seanrieb/daq/README.md

# daq
Data Acquisition Board

Add SparkFun to Arduino IDE board Manager URLs:

https://raw.githubusercontent.com/sparkfun/Arduino_Boards/main/IDE_Board_Manager/package_sparkfun_index.json

Board will be the Pro Micro
