seanrieb/daq/hw/EAGLE/DAQAccel/DAQAccel BOM.xlsx

Qty | Onhand | Vendor | Vendor P/N | Value | Device | Package | Parts | Description
6 | 15 | Mouser | 710-885382206004 | 100nF | CAP-0603 | C0603 | C2, C3, C5, C6, C7, C11 | Ceramic Capacitors
6 | 0 | Mouser | 187-CL10B105KA8NNNC | 1uF | CAP-0603 | C0603 | C1, C4, C8, C9, C10, C12 | Ceramic Capacitors
4 | 12 | Mouser | 512-2N7002L | 2N7002 | MOSFET-N'SOT23' | SOT-23 | Q1, Q2, Q3, Q4 | IRLL014:
8 | 3 | Mouser | 660-RK73B1JTTDD472J | 4.7k | RES-0603 | R0603 | R1, R2, R3, R4, R5, R8, R9, R10
1 | 0 | Mouser | 710-634008149821 | 634008149821 | 634008149821 | 634008149821 | J1 | WR-MJ Modular Jack Horizontal Shielded SMT 8P8C Tab Up
1 |  |  |  | ADXL357 | SENSOR-ADXL357BEZ | LCC-14-TERMINAL | U1
2 |  |  |  | DNP | RES-0603 | R0603 | R6, R7
10 |  |  |  | Test | TEST-POINT'4545' | TP-D45MIL | TP1, TP2, TP3, TP4, TP5, TP6, TP7, TP8, TP9, TP10
1 | 1 | Mouser | 621-AP2125N-3.0TRG1 | XC6206P302MR | PMIC-XC6206PMR | SOT-23 | U2 | LOW ESR Cap.Compatible Positive Voltage Regulators
