seanrieb/daq/hw/EAGLE/DAQShield/DAQShield BOM.xlsx

 | BUILD | 8
Qty | Onhand | Need | Vendor | Vendor P/N | Value | Device | Package | Parts | Description
1 | 11 | -3 | Amazon |  | ARDUINO_PRO_MICRO | ARDUINO_PRO_MICRO | ARDUINO_PRO_MICRO | A1
3 | 167 | -143 | Mouser | 187-CL10A105KA8NFNC | 1u | C-EUC0603 | C0603 | C1, C6, C8 | CAPACITOR, European symbol
1 | 5 | 3 | Mouser | 963-UMK325C7106MM-T | 10u | C-EUC1210 | C1210 | C2 | CAPACITOR, European symbol
2 | 8 | 8 | Mouser | 187-CL10B334KO8NNNC | 0.33u | C-EUC0603 | C0603 | C27, C47 | CAPACITOR, European symbol
2 | 16 | 0 | Mouser | 963-JMK107ABJ106KA-T | 10u | C-EUC0603 | C0603 | C28, C48 | CAPACITOR, European symbol
1 | 5 | 3 | Mouser | 791-0805B104J500CT | 0.1u | C-EUC0805 | C0805 | C3 | CAPACITOR, European symbol
41 | 734 | -406 | Mouser | 187-CL10B104JB8NNNC | 0.1u | C-EUC0603 | C0603 | C4, C7, C9, C10, C11, C12, C13, C14, C15, C16, C17, C18, C19, C20, C21, C22, C23, C24, C25, C26, C29, C30, C31, C32, C33, C34, C35, C36, C37, C38, C39, C40, C41, C42, C43, C44, C45, C46, C49, C50, C51 | CAPACITOR, European symbol
1 | 2 | 6 | Mouser | 187-CL31A106MBHNNNE | 10u | C-EUC0805 | C0805 | C5 | CAPACITOR, European symbol
1 | 5 | 3 | Mouser | 771-PMEG6010CEH-T/R | PMEG6010CEH,115 | SMF5.0AT1 | SOD123FL | D1 | 200 W Transient Voltage Suppressor
1 | 8 | 0 | Mouser | 595-SN74LVC08MDBVREP | 74AHC1G08DBV | 74AHC1G08DBV | SOT23-5 | IC1 | 2-input AND gate
2 | 4 | 12 | Mouser | 200-SSM112FSHTR |  | 6100XX13321_61001213321 | 61001213321 | J1, J2 | WR-PHD 2.54 mm SMT Socket Header
3 | 8 | 16 | Mouser | 710-634008149821 | 634008149821 | 634008149821 | 634008149821 | J3, J4, J6 | WR-MJ Modular Jack Horizontal Shielded SMT 8P8C Tab Up
1 | 1 | 7 | Newark | 45X4591 |  | 6180XX330923_618044330923 | 618044330923 | J5 | WR-DSUB Female High Density Angled PCB Connector w. Hex Screw
1 | 5 | 3 | Mouser | 652-SRU8043-330Y | 33u | SRU8043-XXXX | IND_BOURNS_SRU8043 | L1
1 | 6 | 2 | Mouser | 604-APA1606QBC/D | APA1606QBC/D | APA1606QBC/D | LED_APA1606_KNB | LED1
10 | 39 | 41 | Mouser | 71-CRCW060347R0FKEAC | 47 | R-EU_R0603 | R0603 | R1, R2, R3, R4, R5, R6, R7, R8, R9, R10 | RESISTOR, European symbol
1 | 6 | 2 | Mouser | 594-MCT06030C1100FP5 | 110 | R-EU_R0603 | R0603 | R11 | RESISTOR, European symbol
1 | 5 | 3 | Mouser | 603-RT0402FRE0757K6L | 57.6k | R-EU_R0402 | R0402 | R12 | RESISTOR, European symbol
1 | 5 | 3 | Mouser | 603-RT0805BRD0710K4L | 10.4k | R-EU_R0805 | R0805 | R13 | RESISTOR, European symbol
6 | 142 | -94 | Mouser | 603-RT0603FRD0710KL | 10k | R-EU_R0603 | R0603 | R14, R15, R17, R22, R39, R58 | RESISTOR, European symbol
1 | 0 | 8 | Mouser | 756-PCF0603R39K2BI | 39.2k | R-EU_R0603 | R0603 | R16 | RESISTOR, European symbol
1 | 0 | 8 | Mouser | 66-PCFW0603LF032002B | 20k | R-EU_R0603 | R0603 | R18 | RESISTOR, European symbol
1 | 0 | 8 | Mouser | 756-PCF0603R82K5BI | 82.5k | R-EU_R0603 | R0603 | R19 | RESISTOR, European symbol
1 | 35 | -27 | Mouser | 603-RT0603DRE07120RL | 120 | R-EU_R0603 | R0603 | R20 | RESISTOR, European symbol
26 | 114 | 94 | Mouser | 667-ERA-3AED151V | 150 | R-EU_R0603 | R0603 | R23, R24, R25, R26, R27, R28, R29, R30, R31, R32, R33, R34, R36, R42, R43, R44, R45, R46, R47, R48, R49, R50, R51, R52, R53, R55 | RESISTOR, European symbol
2 | 17 | -1 | Mouser | 667-ERA-3AEB102V | 1k | R-EU_R0603 | R0603 | R35, R54 | RESISTOR, European symbol
4 | 193 | -161 | Mouser | 603-RC0603JR-070RL | 0 | R-EU_R0603 | R0603 | R37, R38, R56, R57 | RESISTOR, European symbol
6 | 82 | -34 | Mouser | 603-RC1206JR-070RL | 0 | R-EU_R1206 | R1206 | R40, R41, R59, R60, R61, R62 | RESISTOR, European symbol
1 | 5 | 3 | Mouser | 710-434153017835 | 434153017835 | 434153017835 | 434153017835 | S1 | WS-TASV J-Bend SMT Tact Switch 3.5x2.9 mm
2 | 6 | 10 | Mouser | 710-450404015514 |  | 450404015514 | 450404015514 | S2, S4 | WS-SLSU Mini Slide Switch, Same Side Connection Side Push 6.7x2.7 mm
1 | 14 | -6 | Digikey | 428427320910-ND |  | 428427320910 | 42842732091X_10POS | S3 | WS-ROTU THT Rotary Switch Right Angled with Arrow Type Actuator, 2.54 mm Pitch, 10x10 mm
1 | 6 | 2 | Mouser | 710-452403012014 |  | 452403012014 | 452403012014 | S5 | WS-SLSV SMD Mini Slide Switch, Same Side Connection 7.65 x 5.5 mm
1 | 3 | 5 | Texas Instruments | SN74LVC1G125DBVR | Value | 74LVC1G125DBVRE4 | DBV0005A_N | U1
1 | 2 | 6 | Texas Instruments | LV2862XLVDDCT/R | LV2862XLVDDCR | LV2862XLVDDCR | DDC0006A-IPC_A | U2
1 | 7 | 1 | Mouser | 595-TPS3828-50DBVT | TPS3828-50DBVT | TPS3828-50DBVT | SOT95P280X145-5N | U3 | Check prices
1 | 6 | 2 | Mouser | 595-TPS7A0533PDBZT | XC6206P302MR | XC6206P302MR | SOT95P280X130-3N | U4 | Linear Voltage Regulator IC 1 Output 200mA SOT-23 Check prices
1 | 2 | 6 | Mouser | 700-MAX3491ECSD | MAX3491ECSD+ | MAX3491ECSD+ | SOIC127P600X175-14N | U5 | Check prices
2 | 6 | 10 | Mouser | ADS114S08BIPBSR | ADS114S08BS | ADS114S08BIPBS | PBS0032A_N | U6, U7
