seanrieb/daq/hw/EAGLE/DAQAccel/DAQAccel.step

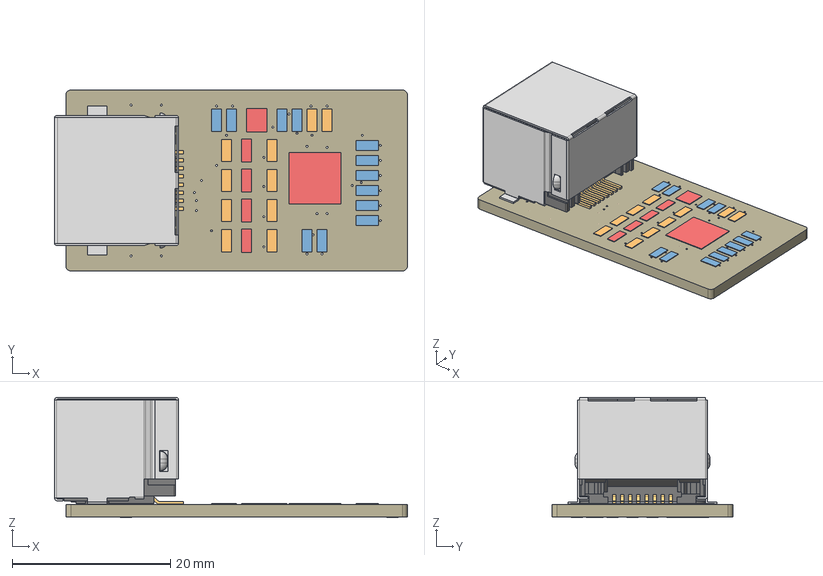
[picture p1: CAD file, 2024-06-11]
hw/EAGLE/DAQAccel/DAQAccel.step
44.6 x 22.9 x 15.2 mm
Board
1uF x 12
634008149821_Housing
634008149821_Housing2
634008149821_Pin x 8
634008149821_Shielding
2N7002 x 4
4.7k x 10
Test x 10
ADXL357
XC6206P302MR
