seanrieb/daq/hw/EAGLE/DAQShield/DAQShield.pdf

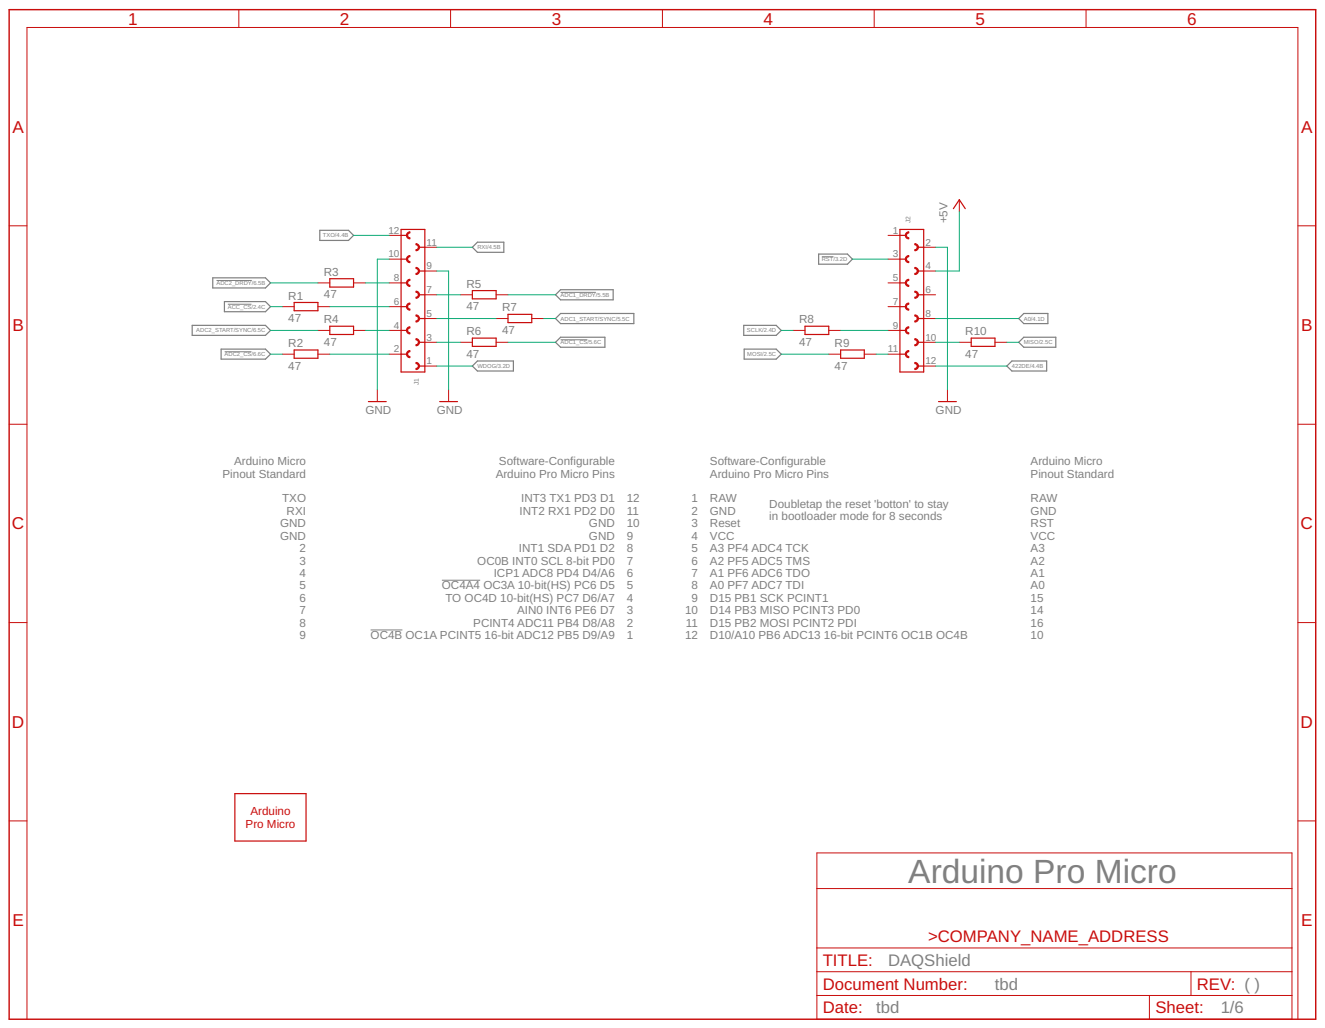
[picture p2: page 1]

Arduino Micro Pinout Standard TXO

Software-Configurable Arduino Pro Micro Pins

Software-Configurable Arduino Pro Micro Pins RAW

Arduino Micro Pinout Standard RAW

Doubletap the reset 'botton' to stay
in bootloader mode for 8 seconds

A3 PF4 ADC4 TCK
A2 PF5 ADC5 TMS
A1 PF6 ADC6 TDO
A0 PF7 ADC7 TDI D15 PB1 SCK PCINT1 D14 PB3 MISO PCINT3 PD0 D15 PB2 MOSI PCINT2 PDI D10/A10 PB6 ADC13 16-bit PCINT6 OC1B OC4B

OC4A4 OC3A 10-bit(HS) PC6 D5 TO OC4D 10-bit(HS) PC7 D6/A7 AIN0 INT6 PE6 D7 PCINT4 ADC11 PB4 D8/A8

Document Number: tbd | REV: ( )
Date: tbd | Sheet: 1/6

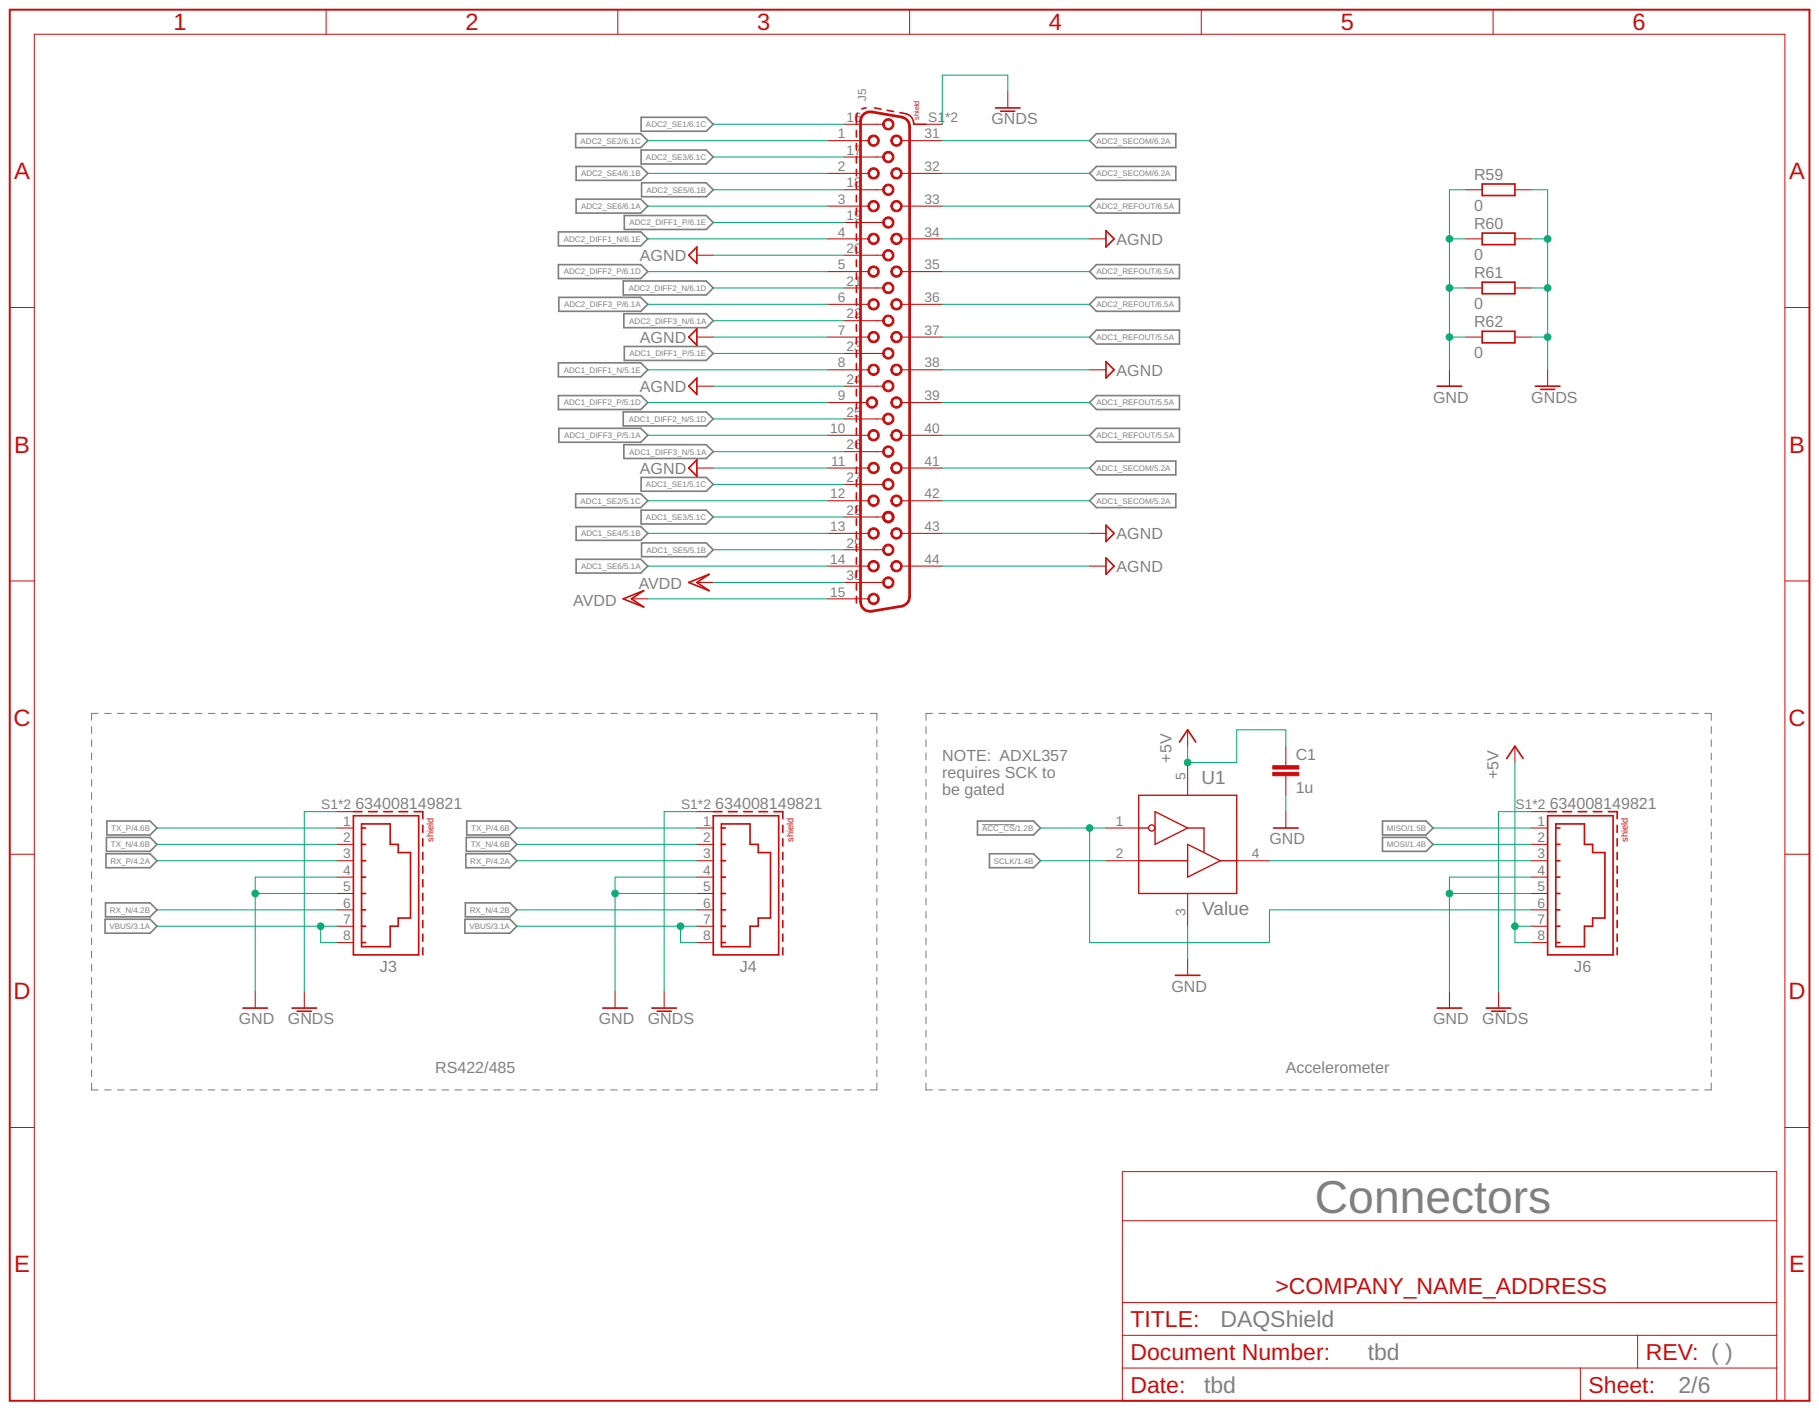
[picture p3: page 2]

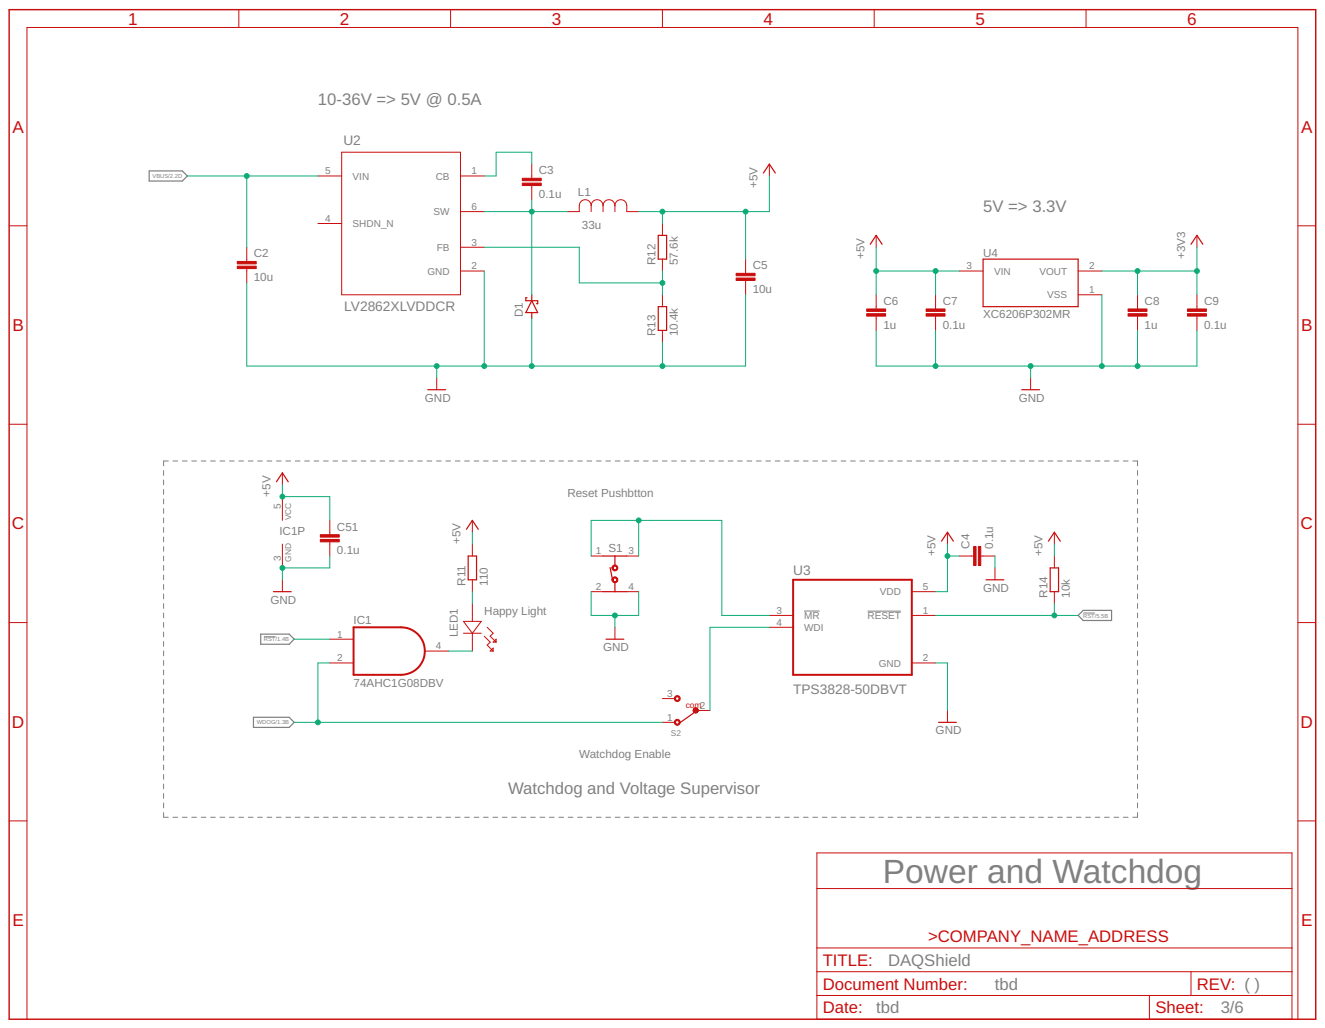
[picture p4: page 3]

2 VSS

Watchdog and Voltage Supervisor

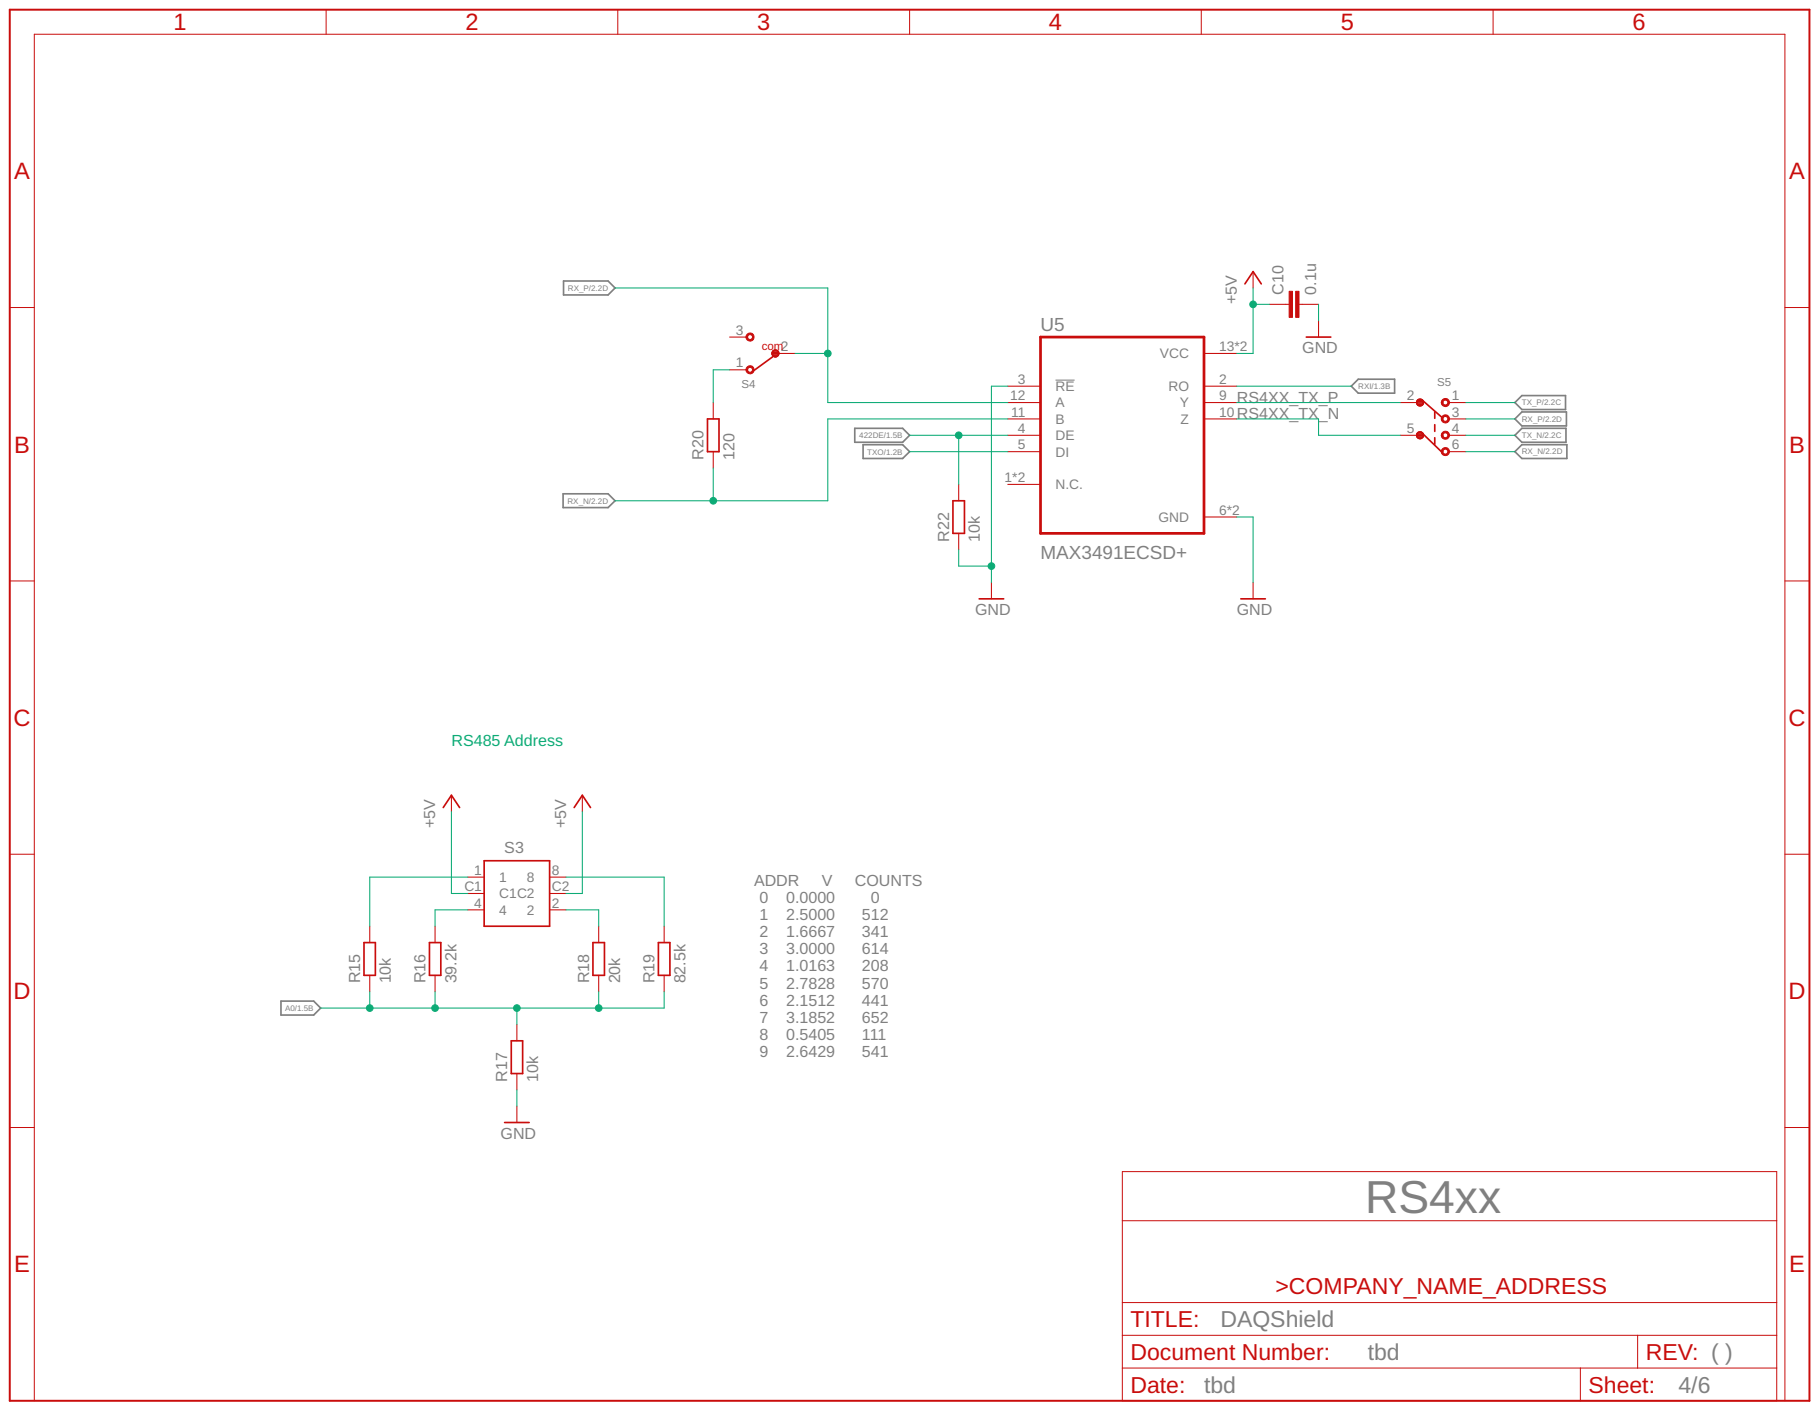
[picture p5: page 4]

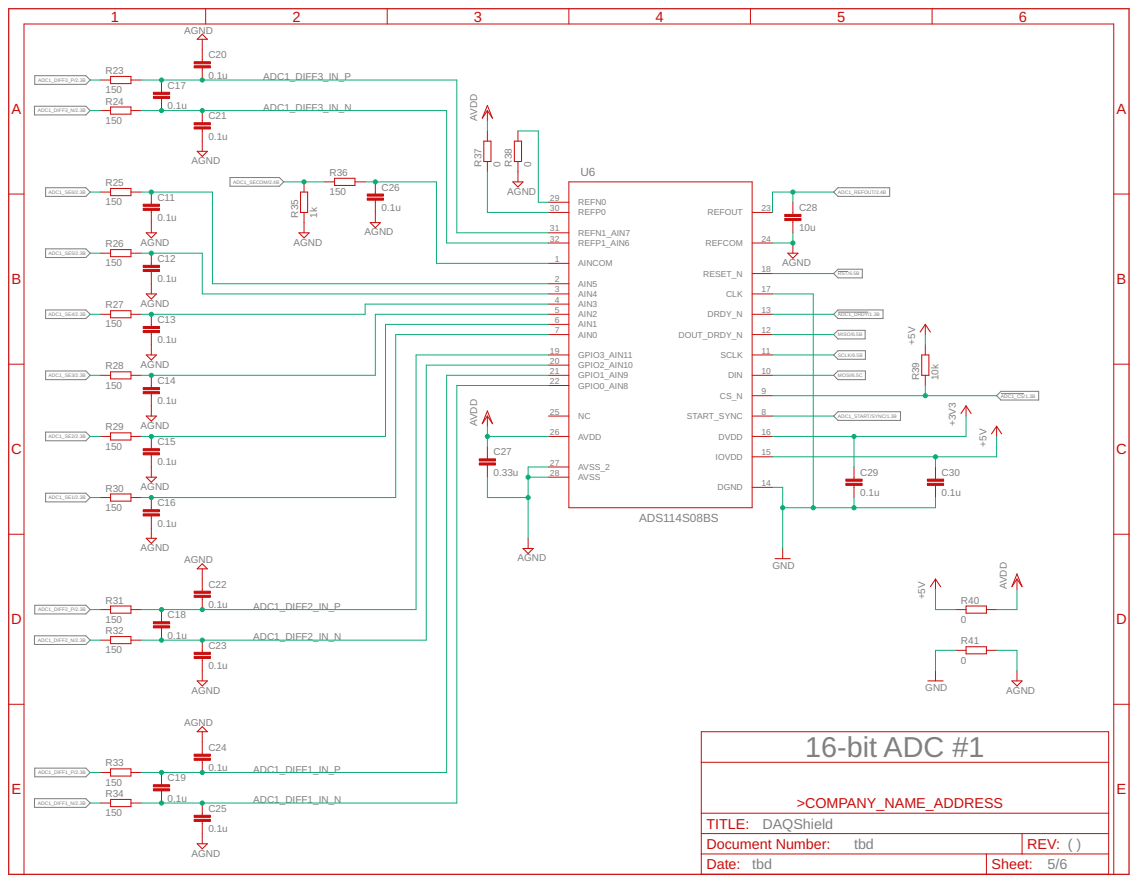
[picture p6: page 5]

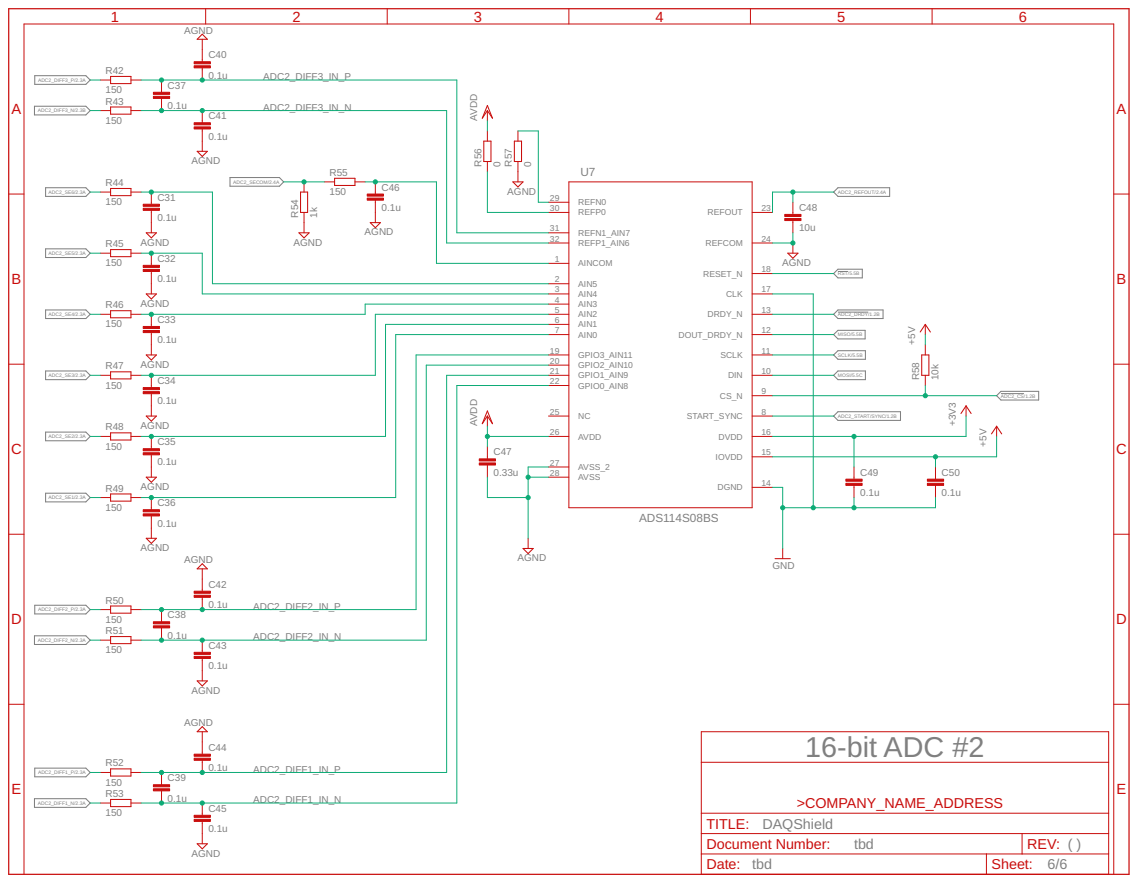
[picture p7: page 6]
