seanrieb/daq/hw/EAGLE/DAQAccel/DAQAccel.pdf

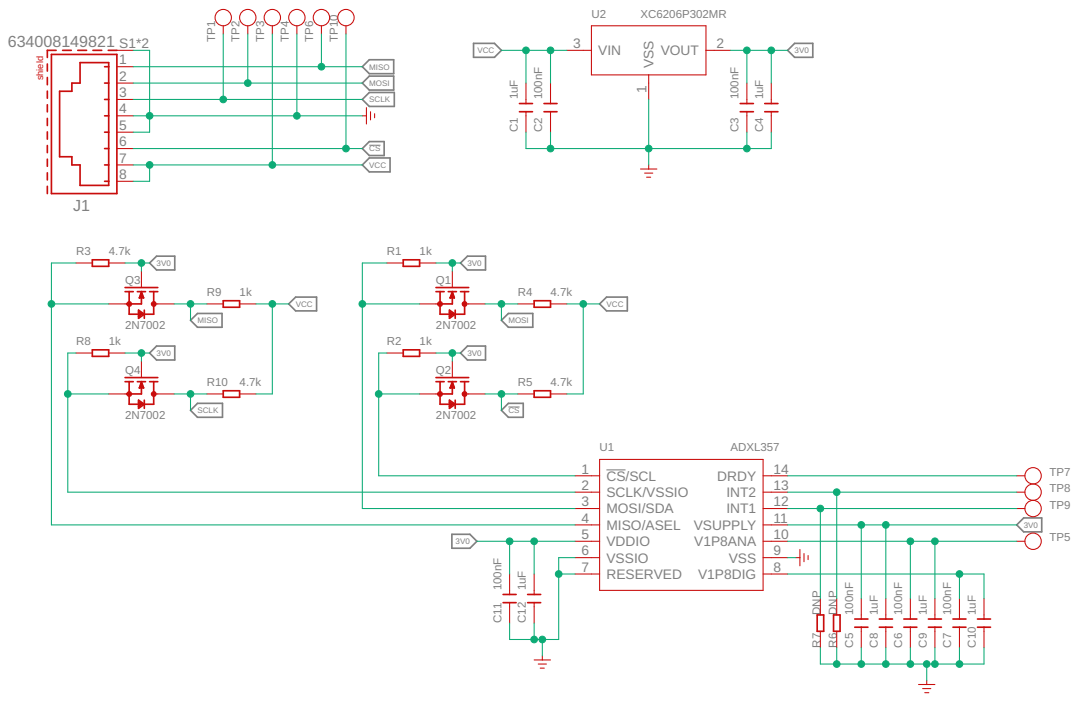
[picture p8: page 1]

4 | SCLK

8 | VCC

Document Number: tbd | REV: ( )
Date: tbd | Sheet: 1/1
