seanrieb/daq/hw/EAGLE/DAQShield/DAQShield.brd

## EAGLE design hw/EAGLE/DAQShield/DAQShield.brd (2024-06-11)

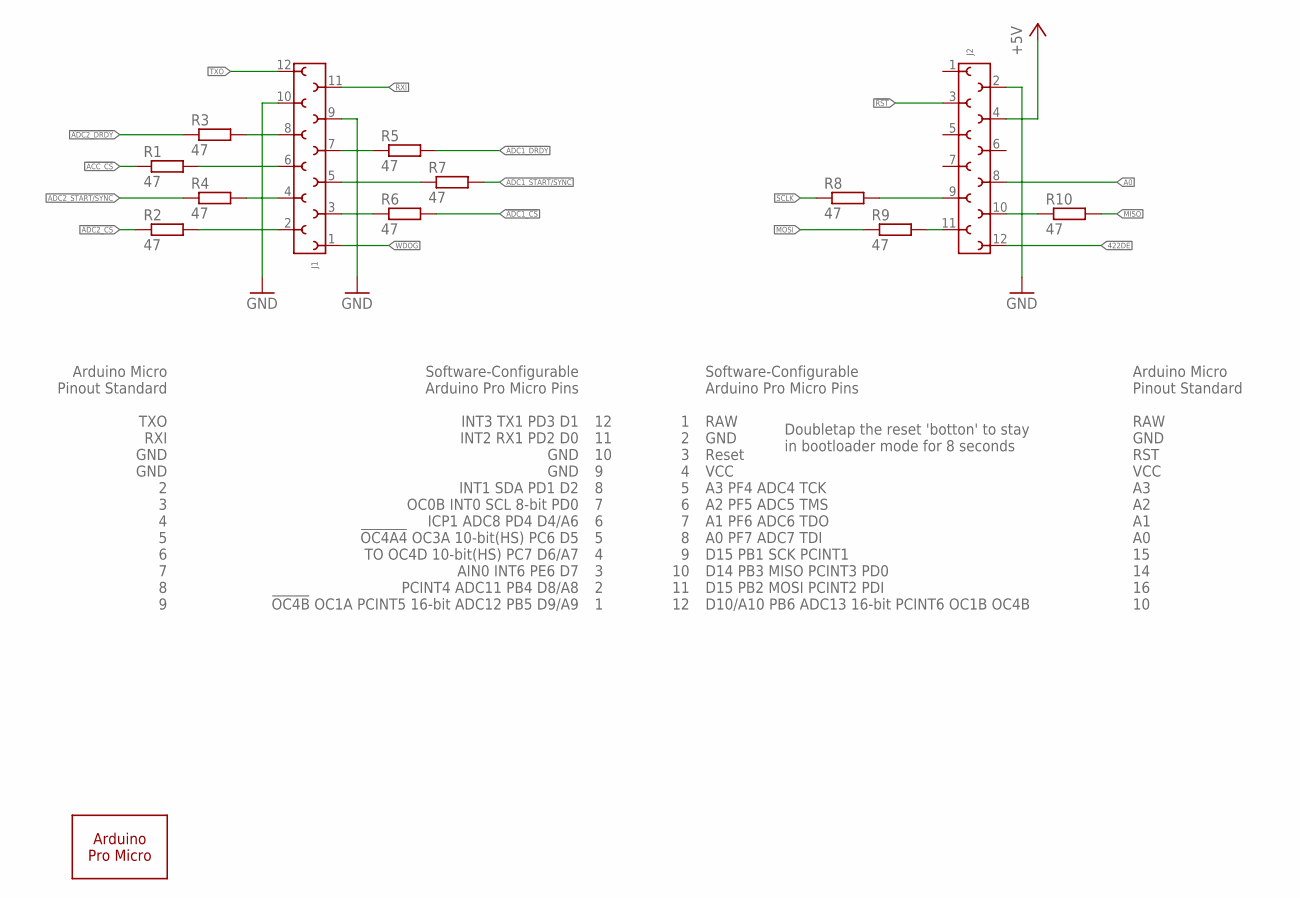
[picture p9: schematic DAQShield.sch, sheet 1, Arduino Pro Micro]

Parts:
A1: ARDUINO_PRO_MICRO
J1, J2: 6100XX13321_61001213321; 61001213321
R1, R2, R3, R4, R5, R6, R7, R8, R9, R10: 47; R0603

Connections:
422DE: J2.12; also elsewhere on the board
!ACC_CS: R1.1; also elsewhere on the board
!ADC1_CS: R6.2; also elsewhere on the board
!ADC1_DRDY: R5.2; also elsewhere on the board
!ADC2_CS: R2.1; also elsewhere on the board
!ADC2_DRDY: R3.1; also elsewhere on the board
!RST: J2.3; also elsewhere on the board
+5V: J2.4; also elsewhere on the board
A0: J2.8; also elsewhere on the board
ADC1_START/SYNC: R7.2; also elsewhere on the board
ADC2_START/SYNC: R4.1; also elsewhere on the board
GND: J1.9, J1.10, J2.2; also elsewhere on the board
MISO: R10.2; also elsewhere on the board
MOSI: R9.1; also elsewhere on the board
unnamed: J2.9, R8.2
unnamed: J2.11, R9.2
unnamed: J2.10, R10.1
unnamed: J1.8, R3.2
unnamed: J1.7, R5.1
unnamed: J1.4, R4.2
unnamed: J1.2, R2.2
unnamed: J1.5, R7.1
unnamed: J1.3, R6.1
unnamed: J1.6, R1.2
RXI: J1.11; also elsewhere on the board
SCLK: R8.1; also elsewhere on the board
TXO: J1.12; also elsewhere on the board
WDOG: J1.1; also elsewhere on the board

Notes on the sheet:
Arduino Micro Pinout Standard TXO RXI GND GND 2 3 4 5 6 7 8 9
Software-Configurable Arduino Pro Micro Pins INT3 TX1 PD3 D1 INT2 RX1 PD2 D0 GND GND INT1 SDA PD1 D2 OC0B INT0 SCL 8-bit PD0 ICP1 ADC8 PD4 D4/A6 !OC4A4! OC3A 10-bit(HS) PC6 D5 TO OC4D 10-bit(HS) PC7 D6/A7 AIN0 INT6 PE6 D7 PCINT4 ADC11 PB4 D8/A8 !OC4B! OC1A PCINT5 16-bit ADC12 PB5 D9/A9
12 11 10 9 8 7 6 5 4 3 2 1
1 2 3 4 5 6 7 8 9 10 11 12
Software-Configurable Arduino Pro Micro Pins RAW GND Reset VCC A3 PF4 ADC4 TCK A2 PF5 ADC5 TMS A1 PF6 ADC6 TDO A0 PF7 ADC7 TDI D15 PB1 SCK PCINT1 D14 PB3 MISO PCINT3 PD0 D15 PB2 MOSI PCINT2 PDI D10/A10 PB6 ADC13 16-bit PCINT6 OC1B OC4B
Arduino Micro Pinout Standard RAW GND RST VCC A3 A2 A1 A0 15 14 16 10
Doubletap the reset 'botton' to stay in bootloader mode for 8 seconds

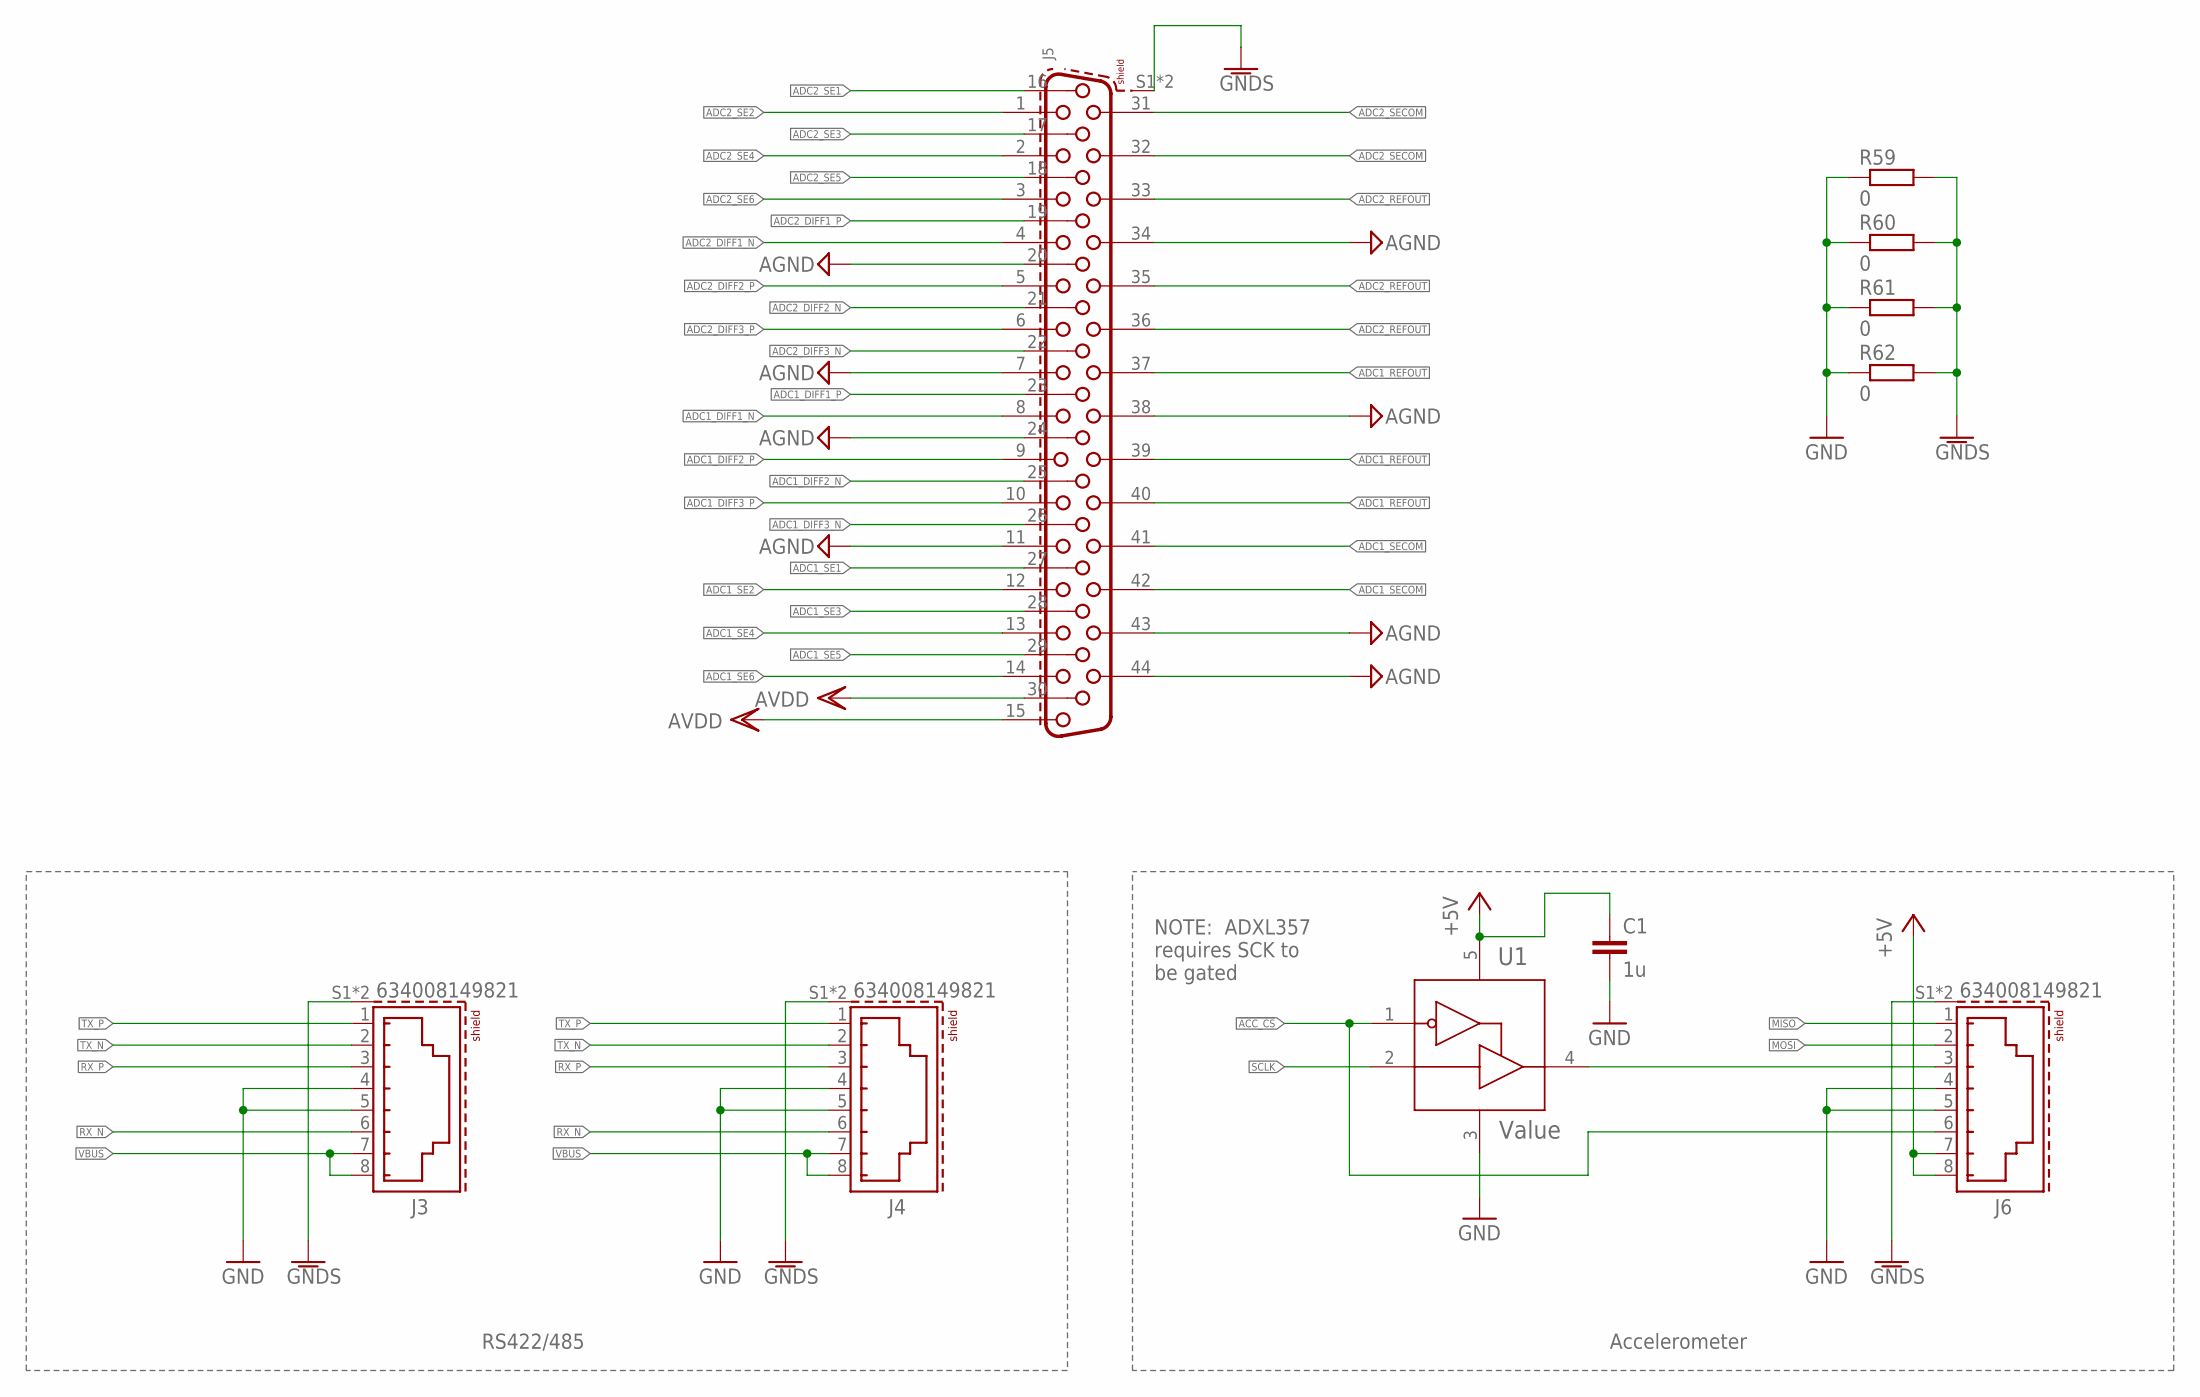
[picture p10: schematic DAQShield.sch, sheet 2, Connectors]

Parts:
C1: 1u; C0603
J3, J4, J6: 634008149821
J5: 6180XX330923_618044330923; 618044330923
R59, R60, R61, R62: 0; R1206
U1: Value; DBV0005A_N

Connections:
!ACC_CS: J6.6, U1.1 (OE_N); also elsewhere on the board
+5V: C1.1, J6.7, J6.8, U1.5 (VCC); also elsewhere on the board
ACC_SCLK: J6.3, U1.4 (Y)
ADC1_DIFF1_N: J5.8; also elsewhere on the board
ADC1_DIFF1_P: J5.23; also elsewhere on the board
ADC1_DIFF2_N: J5.25; also elsewhere on the board
ADC1_DIFF2_P: J5.9; also elsewhere on the board
ADC1_DIFF3_N: J5.26; also elsewhere on the board
ADC1_DIFF3_P: J5.10; also elsewhere on the board
ADC1_REFOUT: J5.37, J5.39, J5.40; also elsewhere on the board
ADC1_SE1: J5.27; also elsewhere on the board
ADC1_SE2: J5.12; also elsewhere on the board
ADC1_SE3: J5.28; also elsewhere on the board
ADC1_SE4: J5.13; also elsewhere on the board
ADC1_SE5: J5.29; also elsewhere on the board
ADC1_SE6: J5.14; also elsewhere on the board
ADC1_SECOM: J5.41, J5.42; also elsewhere on the board
ADC2_DIFF1_N: J5.4; also elsewhere on the board
ADC2_DIFF1_P: J5.19; also elsewhere on the board
ADC2_DIFF2_N: J5.21; also elsewhere on the board
ADC2_DIFF2_P: J5.5; also elsewhere on the board
ADC2_DIFF3_N: J5.22; also elsewhere on the board
ADC2_DIFF3_P: J5.6; also elsewhere on the board
ADC2_REFOUT: J5.33, J5.35, J5.36; also elsewhere on the board
ADC2_SE1: J5.16; also elsewhere on the board
ADC2_SE2: J5.1; also elsewhere on the board
ADC2_SE3: J5.17; also elsewhere on the board
ADC2_SE4: J5.2; also elsewhere on the board
ADC2_SE5: J5.18; also elsewhere on the board
ADC2_SE6: J5.3; also elsewhere on the board
ADC2_SECOM: J5.31, J5.32; also elsewhere on the board
AGND: J5.7, J5.11, J5.20, J5.24, J5.34, J5.38, J5.43, J5.44; also elsewhere on the board
AVDD: J5.15, J5.30; also elsewhere on the board
GND: C1.2, J3.4, J3.5, J4.4, J4.5, J6.4, J6.5, R59.1, R60.1, R61.1, R62.1, U1.3 (GND); also elsewhere on the board
GNDS: J3.S1 (SHIELD), J3.S2 (SHIELD), J4.S1 (SHIELD), J4.S2 (SHIELD), J5.S1 (SHIELD), J5.S2 (SHIELD), J6.S1 (SHIELD), J6.S2 (SHIELD), R59.2, R60.2, R61.2, R62.2
MISO: J6.1; also elsewhere on the board
MOSI: J6.2; also elsewhere on the board
RX_N: J3.6, J4.6; also elsewhere on the board
RX_P: J3.3, J4.3; also elsewhere on the board
SCLK: U1.2 (A); also elsewhere on the board
TX_N: J3.2, J4.2; also elsewhere on the board
TX_P: J3.1, J4.1; also elsewhere on the board
VBUS: J3.7, J3.8, J4.7, J4.8; also elsewhere on the board

Notes on the sheet:
RS422/485
Accelerometer
NOTE: ADXL357 requires SCK to be gated

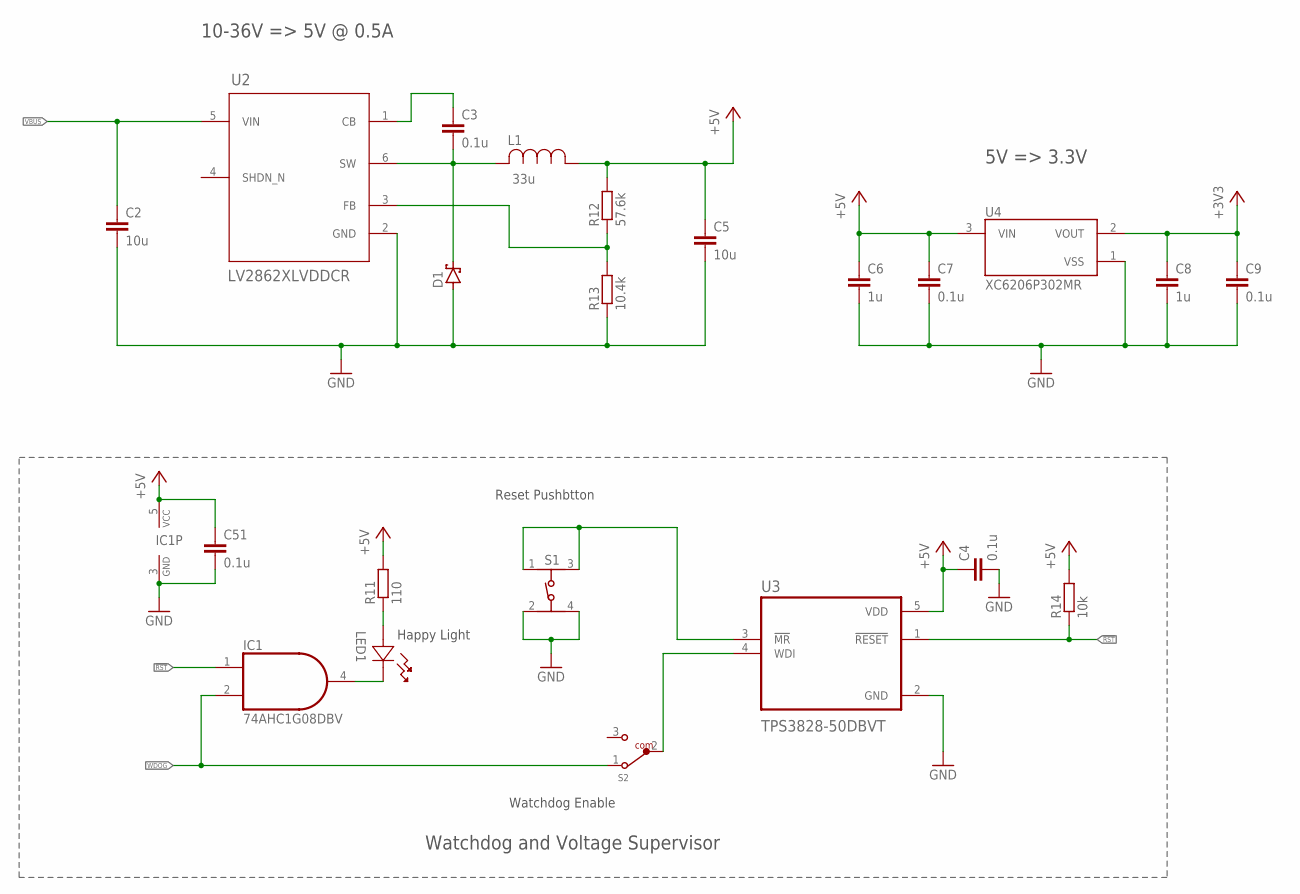
[picture p11: schematic DAQShield.sch, sheet 3, Power and Watchdog]

Parts:
C2: 10u; C1210
C3: 0.1u; C0805
C4, C7, C9, C51: 0.1u; C0603
C5: 10u; C0805
C6, C8: 1u; C0603
D1: PMEG6010CEH,115; SOD123FL
IC1: 74AHC1G08DBV; SOT23-5
L1: 33u; IND_BOURNS_SRU8043
LED1: APA1606QBC/D; LED_APA1606_KNB
R11: 110; R0603
R12: 57.6k; R0402
R13: 10.4k; R0805
R14: 10k; R0603
S1: 434153017835
S2: 450404015514
U2: LV2862XLVDDCR; DDC0006A-IPC_A
U3: TPS3828-50DBVT; SOT95P280X145-5N
U4: XC6206P302MR; SOT95P280X130-3N

Connections:
!RST: IC1.1 (I0), R14.1, U3.1 (!RESET); also elsewhere on the board
+3V3: C8.1, C9.1, U4.2 (VOUT); also elsewhere on the board
+5V: C4.1, C5.1, C6.1, C7.1, C51.1, IC1.5 (VCC), L1.1, R11.2, R12.2, R14.2, U3.5 (VDD), U4.3 (VIN); also elsewhere on the board
GND: C2.2, C4.2, C5.2, C6.2, C7.2, C8.2, C9.2, C51.2, D1.A, IC1.3 (GND), R13.1, S1.2 (3), S1.4, U2.2 (GND), U3.2 (GND), U4.1 (VSS); also elsewhere on the board
unnamed: C3.1, U2.1 (CB)
unnamed: C3.2, D1.C, L1.2, U2.6 (SW)
unnamed: R12.1, R13.2, U2.3 (FB)
unnamed: S1.1, S1.3 (2), U3.3 (!MR)
unnamed: S2.2, U3.4 (WDI)
unnamed: IC1.4 (O), LED1.1
unnamed: LED1.2, R11.1
VBUS: C2.1, U2.5 (VIN); also elsewhere on the board
WDOG: IC1.2 (I1), S2.1; also elsewhere on the board

Notes on the sheet:
10-36V => 5V @ 0.5A
Watchdog and Voltage Supervisor
Reset Pushbtton
Watchdog Enable
Happy Light
5V => 3.3V

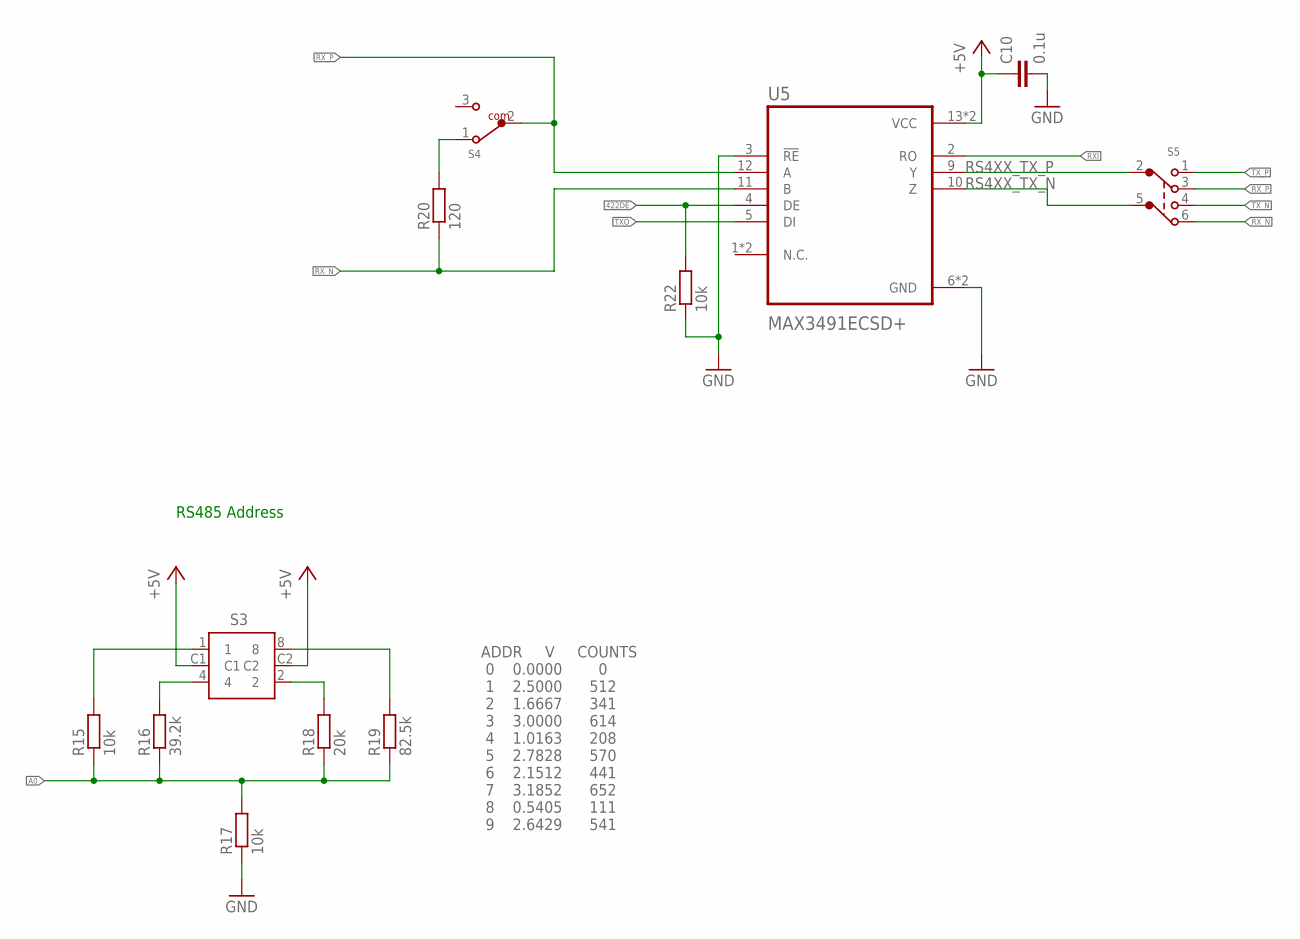
[picture p12: schematic DAQShield.sch, sheet 4, RS4xx]

Parts:
C10: 0.1u; C0603
R15, R17, R22: 10k; R0603
R16: 39.2k; R0603
R18: 20k; R0603
R19: 82.5k; R0603
R20: 120; R0603
S3: 428427320910; 42842732091X_10POS
S4: 450404015514
S5: 452403012014
U5: MAX3491ECSD+; SOIC127P600X175-14N

Connections:
422DE: R22.2, U5.4 (DE); also elsewhere on the board
+5V: C10.1, S3.C1, S3.C2, U5.13 (VCC), U5.14 (VCC); also elsewhere on the board
A0: R15.1, R16.1, R17.2, R18.1, R19.1; also elsewhere on the board
GND: C10.2, R17.1, R22.1, U5.3 (!RE), U5.6 (GND), U5.7 (GND); also elsewhere on the board
unnamed: R20.2, S4.1
unnamed: R15.2, S3.1
unnamed: R16.2, S3.4
unnamed: R19.2, S3.8
unnamed: R18.2, S3.2
RS4XX_TX_N: S5.5, U5.10 (Z)
RS4XX_TX_P: S5.2, U5.9 (Y)
RXI: U5.2 (RO); also elsewhere on the board
RX_N: R20.1, S5.6, U5.11 (B); also elsewhere on the board
RX_P: S4.2, S5.3, U5.12 (A); also elsewhere on the board
TXO: U5.5 (DI); also elsewhere on the board
TX_N: S5.4; also elsewhere on the board
TX_P: S5.1; also elsewhere on the board

Notes on the sheet:
RS485 Address
ADDR V COUNTS 0 0.0000 0 1 2.5000 512 2 1.6667 341 3 3.0000 614 4 1.0163 208 5 2.7828 570 6 2.1512 441 7 3.1852 652 8 0.5405 111 9 2.6429 541

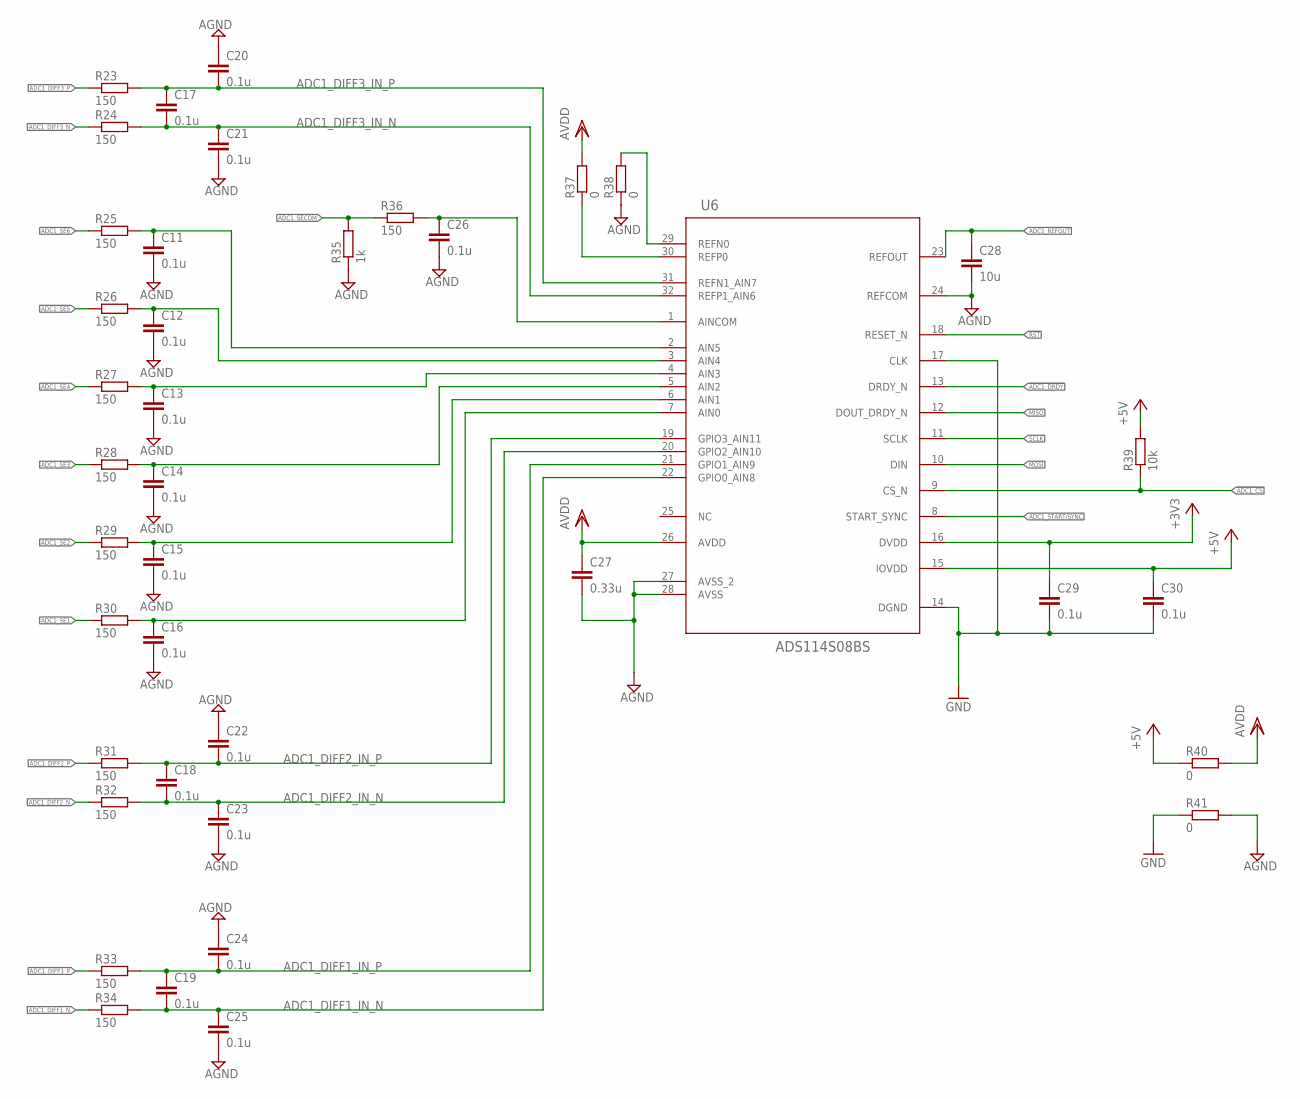
[picture p13: schematic DAQShield.sch, sheet 5, 16-bit ADC #1]

Parts:
C11, C12, C13, C14, C15, C16, C17, C18, C19, C20, C21, C22, C23, C24, C25, C26, C29, C30: 0.1u; C0603
C27: 0.33u; C0603
C28: 10u; C0603
R23, R24, R25, R26, R27, R28, R29, R30, R31, R32, R33, R34, R36: 150; R0603
R35: 1k; R0603
R37, R38: 0; R0603
R39: 10k; R0603
R40, R41: 0; R1206
U6: ADS114S08BS; PBS0032A_N

Connections:
!ADC1_CS: R39.1, U6.9 (CS_N); also elsewhere on the board
!ADC1_DRDY: U6.13 (DRDY_N); also elsewhere on the board
!RST: U6.18 (RESET_N); also elsewhere on the board
+3V3: C29.1, U6.16 (DVDD); also elsewhere on the board
+5V: C30.1, R39.2, R40.1, U6.15 (IOVDD); also elsewhere on the board
ADC1_DIFF1_IN_N: C19.2, C25.1, R34.2, U6.22 (GPIO0_AIN8)
ADC1_DIFF1_IN_P: C19.1, C24.2, R33.2, U6.21 (GPIO1_AIN9)
ADC1_DIFF1_N: R34.1; also elsewhere on the board
ADC1_DIFF1_P: R33.1; also elsewhere on the board
ADC1_DIFF2_IN_N: C18.2, C23.1, R32.2, U6.20 (GPIO2_AIN10)
ADC1_DIFF2_IN_P: C18.1, C22.2, R31.2, U6.19 (GPIO3_AIN11)
ADC1_DIFF2_N: R32.1; also elsewhere on the board
ADC1_DIFF2_P: R31.1; also elsewhere on the board
ADC1_DIFF3_IN_N: C17.2, C21.1, R24.2, U6.32 (REFP1_AIN6)
ADC1_DIFF3_IN_P: C17.1, C20.2, R23.2, U6.31 (REFN1_AIN7)
ADC1_DIFF3_N: R24.1; also elsewhere on the board
ADC1_DIFF3_P: R23.1; also elsewhere on the board
ADC1_REFOUT: C28.1, U6.23 (REFOUT); also elsewhere on the board
ADC1_SE1: R30.1; also elsewhere on the board
ADC1_SE2: R29.1; also elsewhere on the board
ADC1_SE3: R28.1; also elsewhere on the board
ADC1_SE4: R27.1; also elsewhere on the board
ADC1_SE5: R26.1; also elsewhere on the board
ADC1_SE6: R25.1; also elsewhere on the board
ADC1_SECOM: R35.2, R36.1; also elsewhere on the board
ADC1_START/SYNC: U6.8 (START_SYNC); also elsewhere on the board
AGND: C11.2, C12.2, C13.2, C14.2, C15.2, C16.2, C20.1, C21.2, C22.1, C23.2, C24.1, C25.2, C26.2, C27.2, C28.2, R35.1, R38.1, R41.2, U6.24 (REFCOM), U6.27 (AVSS_2), U6.28 (AVSS); also elsewhere on the board
AVDD: C27.1, R37.2, R40.2, U6.26 (AVDD); also elsewhere on the board
GND: C29.2, C30.2, R41.1, U6.14 (DGND), U6.17 (CLK); also elsewhere on the board
MISO: U6.12 (DOUT_DRDY_N); also elsewhere on the board
MOSI: U6.10 (DIN); also elsewhere on the board
unnamed: R37.1, U6.30 (REFP0)
unnamed: R38.2, U6.29 (REFN0)
unnamed: C16.1, R30.2, U6.7 (AIN0)
unnamed: C15.1, R29.2, U6.6 (AIN1)
unnamed: C14.1, R28.2, U6.5 (AIN2)
unnamed: C13.1, R27.2, U6.4 (AIN3)
unnamed: C12.1, R26.2, U6.3 (AIN4)
unnamed: C11.1, R25.2, U6.2 (AIN5)
unnamed: C26.1, R36.2, U6.1 (AINCOM)
SCLK: U6.11 (SCLK); also elsewhere on the board

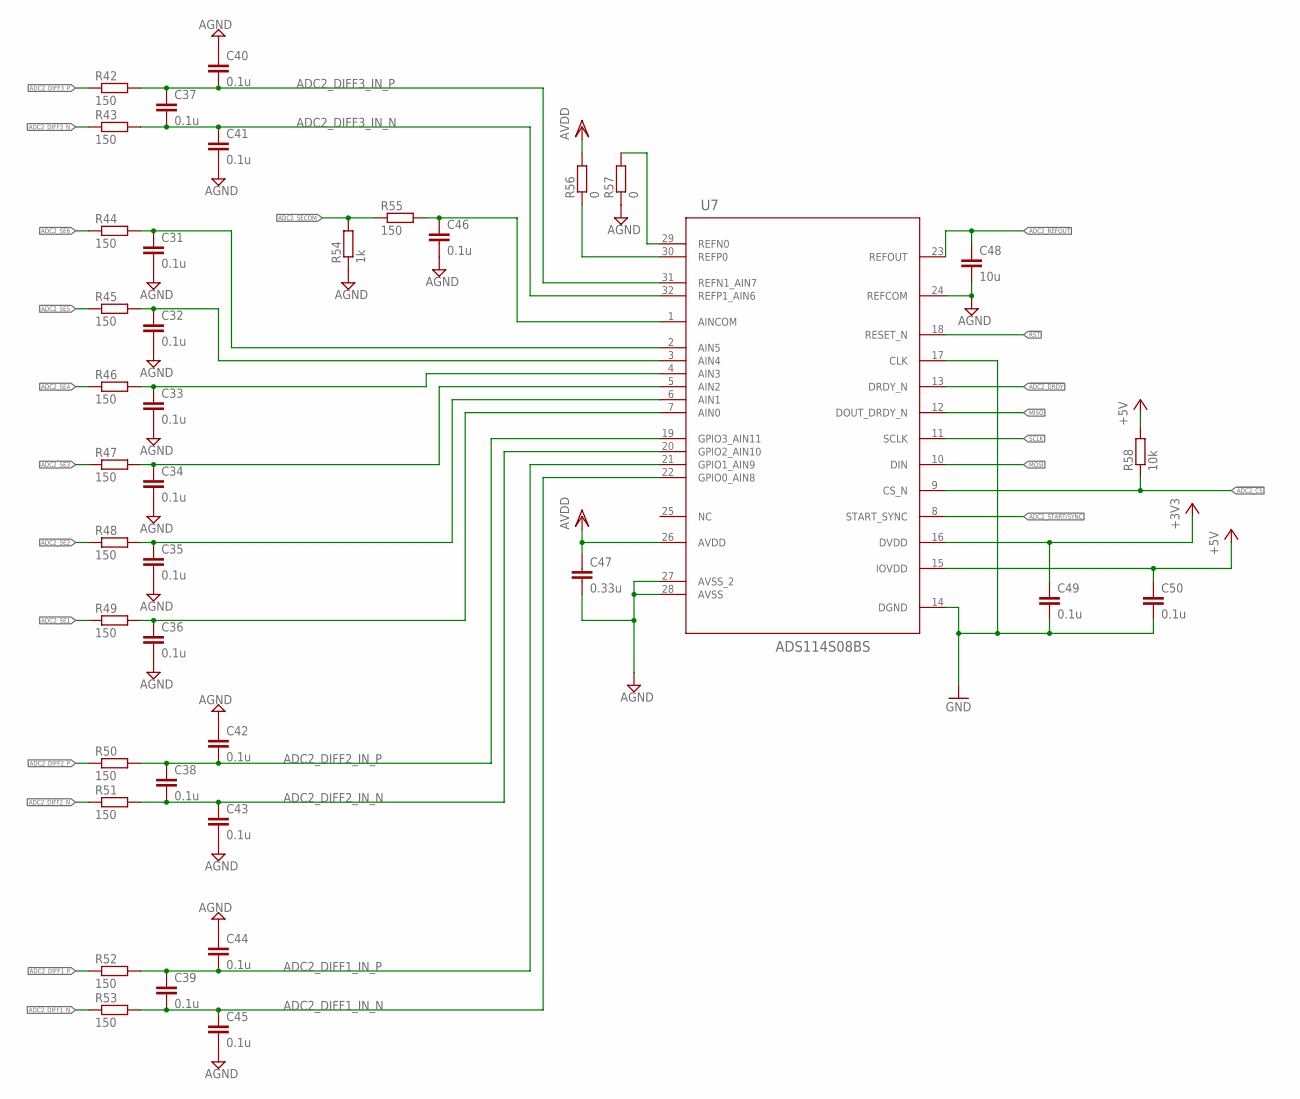
[picture p14: schematic DAQShield.sch, sheet 6, 16-bit ADC #2]

Parts:
C31, C32, C33, C34, C35, C36, C37, C38, C39, C40, C41, C42, C43, C44, C45, C46, C49, C50: 0.1u; C0603
C47: 0.33u; C0603
C48: 10u; C0603
R42, R43, R44, R45, R46, R47, R48, R49, R50, R51, R52, R53, R55: 150; R0603
R54: 1k; R0603
R56, R57: 0; R0603
R58: 10k; R0603
U7: ADS114S08BS; PBS0032A_N

Connections:
!ADC2_CS: R58.1, U7.9 (CS_N); also elsewhere on the board
!ADC2_DRDY: U7.13 (DRDY_N); also elsewhere on the board
!RST: U7.18 (RESET_N); also elsewhere on the board
+3V3: C49.1, U7.16 (DVDD); also elsewhere on the board
+5V: C50.1, R58.2, U7.15 (IOVDD); also elsewhere on the board
ADC2_DIFF1_IN_N: C39.2, C45.1, R53.2, U7.22 (GPIO0_AIN8)
ADC2_DIFF1_IN_P: C39.1, C44.2, R52.2, U7.21 (GPIO1_AIN9)
ADC2_DIFF1_N: R53.1; also elsewhere on the board
ADC2_DIFF1_P: R52.1; also elsewhere on the board
ADC2_DIFF2_IN_N: C38.2, C43.1, R51.2, U7.20 (GPIO2_AIN10)
ADC2_DIFF2_IN_P: C38.1, C42.2, R50.2, U7.19 (GPIO3_AIN11)
ADC2_DIFF2_N: R51.1; also elsewhere on the board
ADC2_DIFF2_P: R50.1; also elsewhere on the board
ADC2_DIFF3_IN_N: C37.2, C41.1, R43.2, U7.32 (REFP1_AIN6)
ADC2_DIFF3_IN_P: C37.1, C40.2, R42.2, U7.31 (REFN1_AIN7)
ADC2_DIFF3_N: R43.1; also elsewhere on the board
ADC2_DIFF3_P: R42.1; also elsewhere on the board
ADC2_REFOUT: C48.1, U7.23 (REFOUT); also elsewhere on the board
ADC2_SE1: R49.1; also elsewhere on the board
ADC2_SE2: R48.1; also elsewhere on the board
ADC2_SE3: R47.1; also elsewhere on the board
ADC2_SE4: R46.1; also elsewhere on the board
ADC2_SE5: R45.1; also elsewhere on the board
ADC2_SE6: R44.1; also elsewhere on the board
ADC2_SECOM: R54.2, R55.1; also elsewhere on the board
ADC2_START/SYNC: U7.8 (START_SYNC); also elsewhere on the board
AGND: C31.2, C32.2, C33.2, C34.2, C35.2, C36.2, C40.1, C41.2, C42.1, C43.2, C44.1, C45.2, C46.2, C47.2, C48.2, R54.1, R57.1, U7.24 (REFCOM), U7.27 (AVSS_2), U7.28 (AVSS); also elsewhere on the board
AVDD: C47.1, R56.2, U7.26 (AVDD); also elsewhere on the board
GND: C49.2, C50.2, U7.14 (DGND), U7.17 (CLK); also elsewhere on the board
MISO: U7.12 (DOUT_DRDY_N); also elsewhere on the board
MOSI: U7.10 (DIN); also elsewhere on the board
unnamed: C36.1, R49.2, U7.7 (AIN0)
unnamed: C35.1, R48.2, U7.6 (AIN1)
unnamed: C34.1, R47.2, U7.5 (AIN2)
unnamed: C33.1, R46.2, U7.4 (AIN3)
unnamed: C32.1, R45.2, U7.3 (AIN4)
unnamed: C31.1, R44.2, U7.2 (AIN5)
unnamed: C46.1, R55.2, U7.1 (AINCOM)
unnamed: R57.2, U7.29 (REFN0)
unnamed: R56.1, U7.30 (REFP0)
SCLK: U7.11 (SCLK); also elsewhere on the board

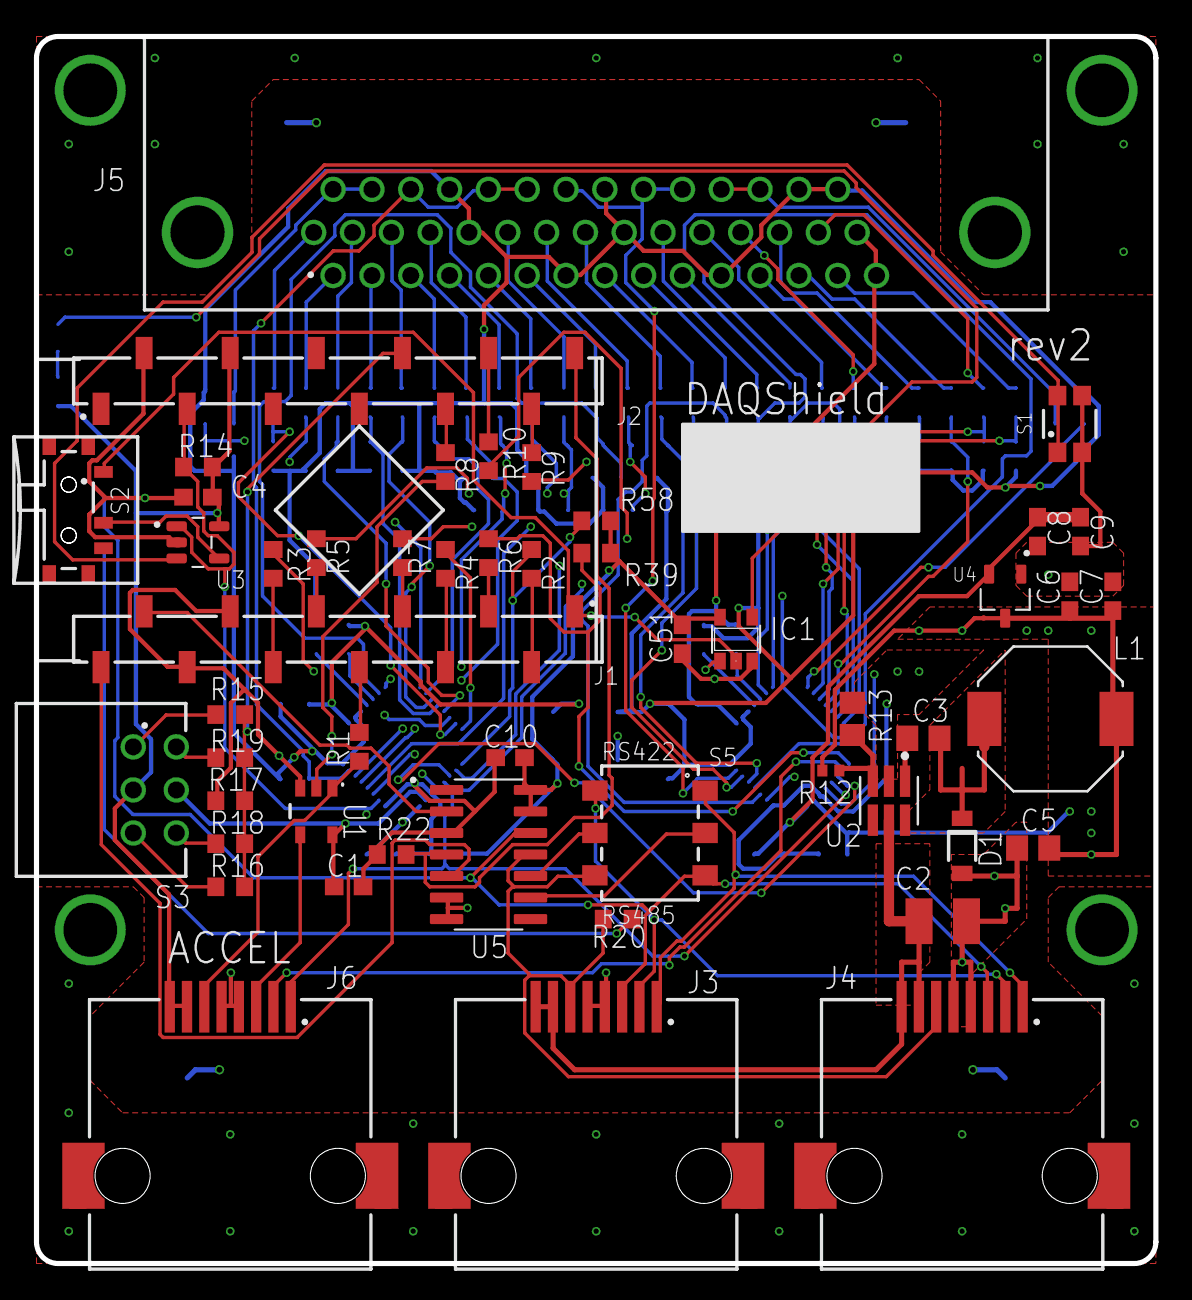
[picture p15: board DAQShield.brd from above]

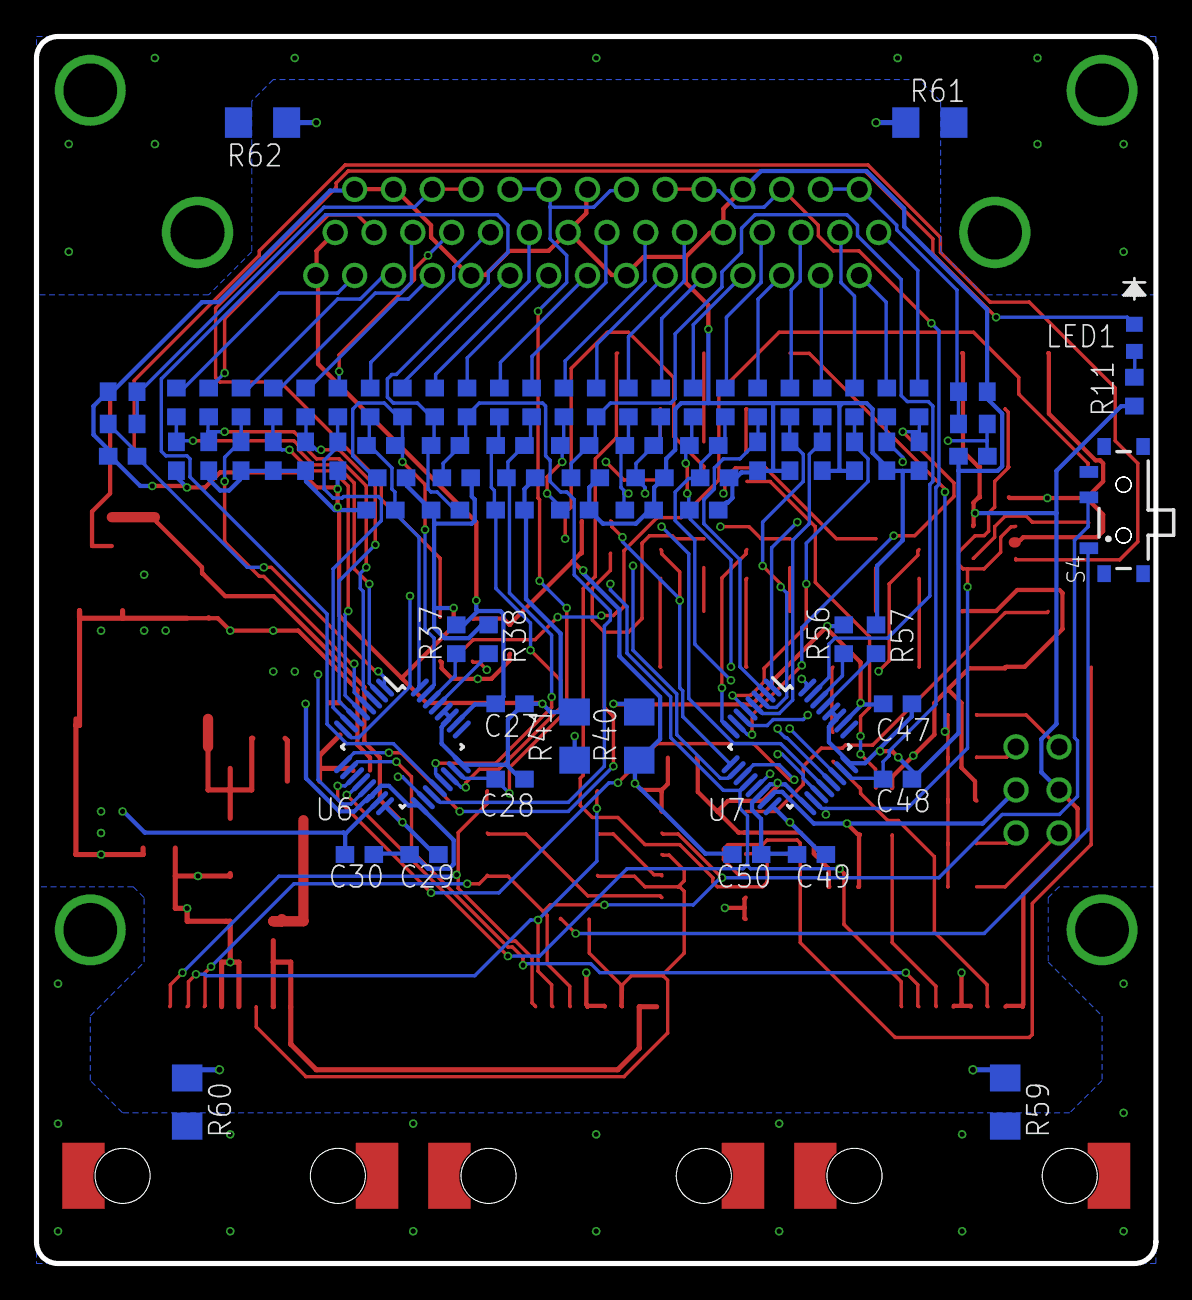
[picture p16: board DAQShield.brd from below]

Board: 6 copper layers, 66.0 x 72.4 mm, 135 parts (83 on the bottom side), 110 nets.
