seanrieb/daq/hw/EAGLE/DAQAccel/DAQAccel.brd

## EAGLE design hw/EAGLE/DAQAccel/DAQAccel.brd (2024-06-11)

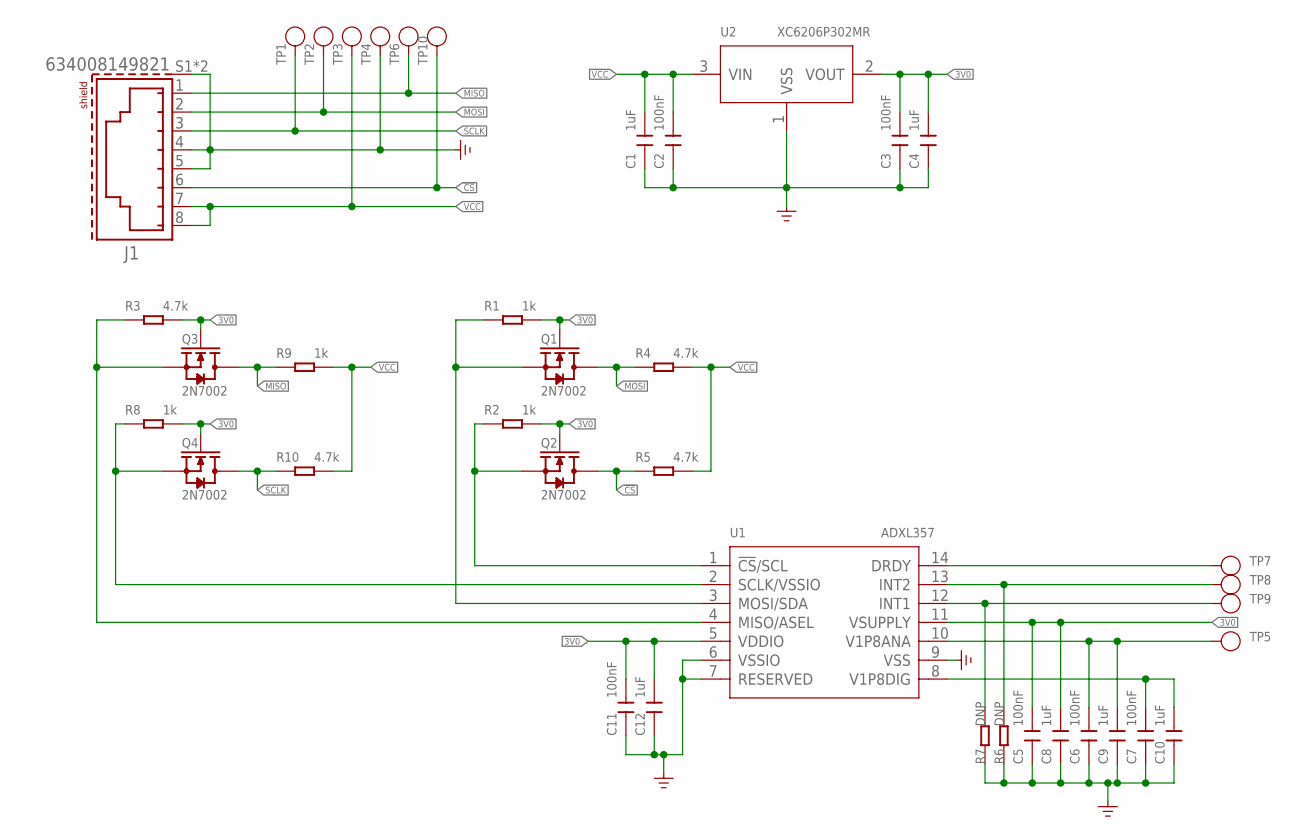
[picture p17: schematic DAQAccel.sch]

Parts:
C1, C4, C8, C9, C10, C12: 1uF; C0603
C2, C3, C5, C6, C7, C11: 100nF; C0603
J1: 634008149821
Q1, Q2, Q3, Q4: 2N7002; SOT-23
R1, R2, R8, R9: 1k; R0603
R3, R4, R5, R10: 4.7k; R0603
R6, R7: DNP; R0603
TP1, TP2, TP3, TP4, TP5, TP6, TP7, TP8, TP9, TP10: Test; TP-D45MIL
U1: ADXL357; LCC-14-TERMINAL
U2: XC6206P302MR; SOT-23

Connections:
3V0: C3.2, C4.2, C5.2, C8.2, C11.2, C12.2, Q1.1 (G), Q2.1 (G), Q3.1 (G), Q4.1 (G), R1.2, R2.2, R3.2, R8.2, U1.5 (VDDIO), U1.11 (VSUPPLY), U2.2 (VOUT)
!CS: J1.6, Q2.3 (D), R5.1, TP10.T
GND: C1.1, C2.1, C3.1, C4.1, C5.1, C6.1, C7.1, C8.1, C9.1, C10.1, C11.1, C12.1, J1.4, J1.5, J1.S1 (SHIELD), J1.S2 (SHIELD), R6.1, R7.1, TP4.T, U1.6 (VSSIO), U1.7 (RESERVED), U1.9 (VSS), U2.1 (VSS)
MISO: J1.1, Q3.3 (D), R9.1, TP6.T
MOSI: J1.2, Q1.3 (D), R4.1, TP2.T
unnamed: Q2.2 (S), R2.1, U1.1 (!CS!/SCL)
unnamed: TP7.T, U1.14 (DRDY)
unnamed: Q1.2 (S), R1.1, U1.3 (MOSI/SDA)
unnamed: R6.2, TP8.T, U1.13 (INT2)
unnamed: C6.2, C9.2, TP5.T, U1.10 (V1P8ANA)
unnamed: Q4.2 (S), R8.1, U1.2 (SCLK/VSSIO)
unnamed: C7.2, C10.2, U1.8 (V1P8DIG)
unnamed: R7.2, TP9.T, U1.12 (INT1)
unnamed: Q3.2 (S), R3.1, U1.4 (MISO/ASEL)
SCLK: J1.3, Q4.3 (D), R10.1, TP1.T
VCC: C1.2, C2.2, J1.7, J1.8, R4.2, R5.2, R9.2, R10.2, TP3.T, U2.3 (VIN)

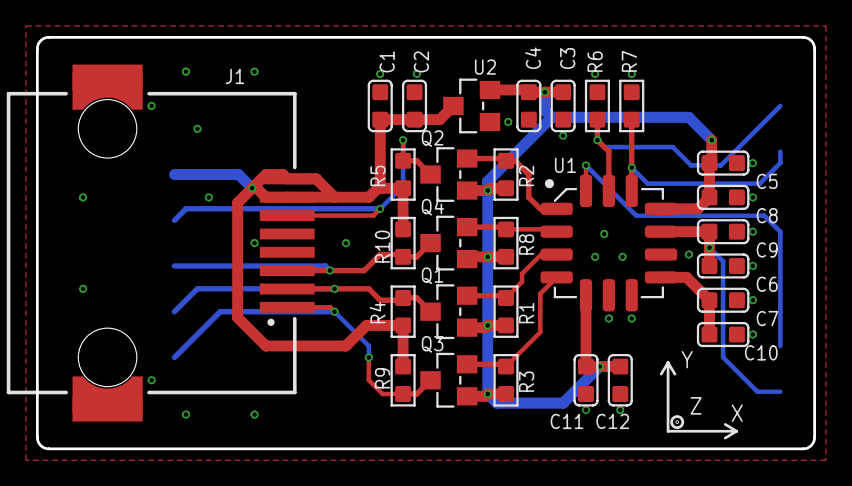
[picture p18: board DAQAccel.brd from above]

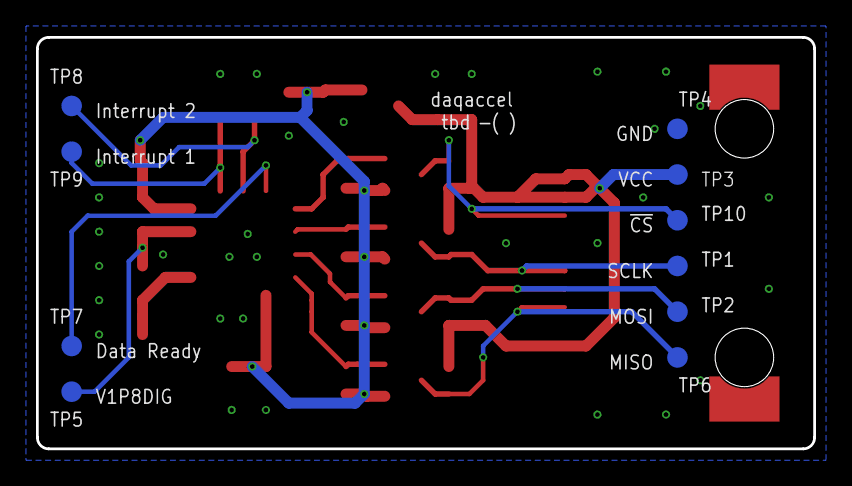
[picture p19: board DAQAccel.brd from below]

Board: 2 copper layers, 43.2 x 22.9 mm, 39 parts (10 on the bottom side), 16 nets.
