seanrieb/daq/(notices)

Notices in the files:
hw/EAGLE/DAQShield/DAQShield.brd:
(C)2003 A. DANNENBERG
parts and their libraries:
WR-MJ: Copyright: Würth Elektronik
DAQParts: COPYRIGHT: Copyright (C) 2018 Accelerated Designs. All rights reserved
